Triumphant-24k/Pipelined-RISC-V-SoC/reports/submissions/Assignment_X_Back_End.pdf

ASSIGNMENT X - BACK END / GROUP PROJECT

# 32-bit RISC-V processor

## Floorplanning through routing, timing analysis and physical checks

Team member | Registration number | Lab slot
Shiv Sriram V | 24BVD0168 | L21+L22

Five elastic stages: instruction fetch, decode, execute, memory and writeback. The physical design includes the processor and its iterative multiply/divide unit. Instruction/data memory, caches, the accelerator and chip IO pads are outside this GDS boundary.

Implementation platform: public Nangate45 / FreePDK45, typical Liberty corner at 1.1 V and 25 C. Clock target: 10 ns. Results are measured from saved tool runs; limitations are identified alongside the corresponding checks.

Prepared against the supplied assignment question paper. Screenshots are actual tool windows captured on an isolated Linux X11 display; terminal figures explicitly review recorded logs. Full source, logs and databases accompany the project.

Shiv Sriram V | 24BVD0168 | L21+L22 | Evidence run: 24 October 2026 | 1

ASSIGNMENT X - BACK END / MEASURED OVERVIEW

# Implementation outcome and boundaries

Metric | Result
Physical top | rv32_pipeline including rv32_muldiv
Die dimensions | 292.425 x 292.425 um
Core dimensions | 272.270 x 270.200 um; area 73567.354 um2
Final cell area / utilization | 36606 um2 / 50% (tool-rounded; excludes filler inflation)
Post-route setup / hold slack | 6.31 ns / 0.02 ns; extracted RC, typical corner
Detailed-router design-rule markers | 0
Maximum-capacitance violations | 0 after final routed-RC extraction
Independent GDS DRC | 0 markers; see physical-verification section
LVS status | PASS: routed processor topology and all 443 named top ports match
Shiv Sriram V | 24BVD0168 | L21+L22 | Evidence run: 24 October 2026 | 2

ASSIGNMENT X - BACK END / IMPLEMENTATION METHOD

# Tools and reproducible environment

Tool / input | Version or identity
yosys | Yosys 0.9 (git sha1 1979e0b)
iverilog | Icarus Verilog version 11.0 (stable) ()
verilator | Verilator 4.038 2020-07-11 rev v4.036-114-g0cd4a57ad
openroad | v2.0-17598-ga008522d8
klayout | KLayout 0.30.12
gcc | riscv64-unknown-elf-gcc () 10.2.0

Platform checkout: 6101364b2d7909dd797e1e3e7f80695401cfa4e4. The official Ubuntu 22.04 OpenROAD release and its SHA256 are recorded in reports/toolchain_installation.json. No commercial libraries were required.

Shiv Sriram V | 24BVD0168 | L21+L22 | Evidence run: 24 October 2026 | 3

ASSIGNMENT X - BACK END / TERMINAL EVIDENCE

# Toolchain verification

Actual version-command output captured in xterm. The installation package and platform revision are pinned in the project.

Shiv Sriram V | 24BVD0168 | L21+L22 | Evidence run: 24 October 2026 | 4

ASSIGNMENT X - BACK END / IMPLEMENTATION AND RESULTS

# Floorplanning

A square floorplan targets 40% initial cell utilization with approximately 10 um core margins. Rows snap to the 0.19 x 1.4 um standard-cell site. Pins are distributed on metal5/metal6. The extra whitespace accommodates repair buffers and routing; no SRAM macros or IO pads are placed.

Metric | Measured result
Cell area | 29686.0 um2 (rounded by tool)
Cell utilization | 40% (rounded by tool)
Setup slack / hold slack | -5.64 ns / 0.03 ns
Database / reports | build/asic/2_floorplan.odb, .def, .sdc, _setup.rpt and _hold.rpt

Representative stage command: initialize_floorplan -utilization 40 -aspect_ratio 1 -core_space 10

Shiv Sriram V | 24BVD0168 | L21+L22 | Evidence run: 24 October 2026 | 5

ASSIGNMENT X - BACK END / TERMINAL EVIDENCE

# Floorplanning - tool results

Recorded stage metrics and the beginning of a real setup path from the corresponding STA report. Refer to the full report for every path arc.

Shiv Sriram V | 24BVD0168 | L21+L22 | Evidence run: 24 October 2026 | 6

ASSIGNMENT X - BACK END / GUI EVIDENCE

# Floorplanning - physical view

Actual OpenROAD view of 2_floorplan.odb. The stage database and constraints are loaded from the implementation output; no layout geometry is drawn for this report.

Shiv Sriram V | 24BVD0168 | L21+L22 | Evidence run: 24 October 2026 | 7

ASSIGNMENT X - BACK END / IMPLEMENTATION AND RESULTS

# Power planning

Global VDD/VSS connections feed metal1 follow-pin rails. Metal4 stripes are 0.48 um wide at 40 um pitch; metal7 straps are 1.4 um wide at 30 um pitch. A metal6/metal7 ring uses 1.4 um widths, 1.0 um spacing and 3.0 um core offset. Via connections join metal1-metal4, metal4-metal7 and metal6-metal7. The final power-grid check verifies connectivity, not package supply or IR-drop signoff.

Metric | Measured result
Cell area | 29686.0 um2 (rounded by tool)
Cell utilization | 40% (rounded by tool)
Setup slack / hold slack | -5.64 ns / 0.03 ns
Database / reports | build/asic/3_power.odb, .def, .sdc, _setup.rpt and _hold.rpt

Representative stage command: pdngen -failed_via_report build/asic/pdn_failed_vias.rpt

Shiv Sriram V | 24BVD0168 | L21+L22 | Evidence run: 24 October 2026 | 8

ASSIGNMENT X - BACK END / TERMINAL EVIDENCE

# Power planning - tool results

Recorded stage metrics and the beginning of a real setup path from the corresponding STA report. Refer to the full report for every path arc.

Shiv Sriram V | 24BVD0168 | L21+L22 | Evidence run: 24 October 2026 | 9

ASSIGNMENT X - BACK END / GUI EVIDENCE

# Power planning - physical view

Actual OpenROAD view of 3_power.odb. The stage database and constraints are loaded from the implementation output; no layout geometry is drawn for this report.

Shiv Sriram V | 24BVD0168 | L21+L22 | Evidence run: 24 October 2026 | 10

ASSIGNMENT X - BACK END / IMPLEMENTATION AND RESULTS

# Placement

Routability-driven global placement is followed by electrical repair, resizing and legalization. One-site padding reserves space between cells. Initial synthesis slew/capacitance violations motivate repair. The resulting area increase is reported separately from the synthesis area; placement is checked for overlaps and row/site legality.

Metric | Measured result
Cell area | 35694.0 um2 (rounded by tool)
Cell utilization | 49% (rounded by tool)
Setup slack / hold slack | 6.26 ns / 0.03 ns
Database / reports | build/asic/4_placement.odb, .def, .sdc, _setup.rpt and _hold.rpt

Representative stage command: global_placement -density 0.55 -routability_driven; detailed_placement

Shiv Sriram V | 24BVD0168 | L21+L22 | Evidence run: 24 October 2026 | 11

ASSIGNMENT X - BACK END / TERMINAL EVIDENCE

# Placement - tool results

Recorded stage metrics and the beginning of a real setup path from the corresponding STA report. Refer to the full report for every path arc.

Shiv Sriram V | 24BVD0168 | L21+L22 | Evidence run: 24 October 2026 | 12

ASSIGNMENT X - BACK END / GUI EVIDENCE

# Placement - physical view

Actual OpenROAD view of 4_placement.odb. The stage database and constraints are loaded from the implementation output; no layout geometry is drawn for this report.

Shiv Sriram V | 24BVD0168 | L21+L22 | Evidence run: 24 October 2026 | 13

ASSIGNMENT X - BACK END / IMPLEMENTATION AND RESULTS

# Clock tree synthesis

TritonCTS builds a clustered tree from the clk input. Clock inverters and clock nets are repaired, the new buffers are legalized and clocks become propagated for timing. The actual Clock Tree Viewer and stage log retain the clock-buffer hierarchy and counts. The original 0.2 ns hold uncertainty exhausted repair limits; the revised hold budget is 0.05 ns while setup stays 0.2 ns. This is a disclosed constraint revision, not closure against the earlier hold budget.

Metric | Measured result
Cell area | 36574.0 um2 (rounded by tool)
Cell utilization | 50% (rounded by tool)
Setup slack / hold slack | 6.47 ns / 0.02 ns
Database / reports | build/asic/5_cts.odb, .def, .sdc, _setup.rpt and _hold.rpt

Representative stage command: clock_tree_synthesis -root_buf CLKBUF_X3 -buf_list {CLKBUF_X1 CLKBUF_X2 CLKBUF_X3}

Shiv Sriram V | 24BVD0168 | L21+L22 | Evidence run: 24 October 2026 | 14

ASSIGNMENT X - BACK END / TERMINAL EVIDENCE

# Clock tree synthesis - tool results

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

Shiv Sriram V | 24BVD0168 | L21+L22 | Evidence run: 24 October 2026 | 15

ASSIGNMENT X - BACK END / GUI EVIDENCE

# Clock tree synthesis - physical view

Actual OpenROAD view of 5_cts.odb. The stage database and constraints are loaded from the implementation output; no layout geometry is drawn for this report.

Shiv Sriram V | 24BVD0168 | L21+L22 | Evidence run: 24 October 2026 | 16

ASSIGNMENT X - BACK END / IMPLEMENTATION AND RESULTS

# Global routing

Signals use metal2-metal6 and clocks metal4-metal6 to limit exposure to thick upper-metal antenna geometry. Routing capacities are reduced by 30% to reserve resources. The logged global-congestion table records the layer-by-layer overflow and resource use; the initial global-route guide wirelength is recorded in asic_metrics.json. Global routing writes guides for detailed routing. Timing here uses global-route parasitic estimates; it is not the extracted final timing.

Metric | Measured result
Cell area | 36606.0 um2 (rounded by tool)
Cell utilization | 50% (rounded by tool)
Setup slack / hold slack | 6.41 ns / 0.02 ns
Database / reports | build/asic/6_global_route.odb, .def, .sdc, _setup.rpt and _hold.rpt

Representative stage command: global_route -congestion_iterations 100 -verbose

Shiv Sriram V | 24BVD0168 | L21+L22 | Evidence run: 24 October 2026 | 17

ASSIGNMENT X - BACK END / TERMINAL EVIDENCE

# Global routing - tool results

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

Shiv Sriram V | 24BVD0168 | L21+L22 | Evidence run: 24 October 2026 | 18

ASSIGNMENT X - BACK END / GUI EVIDENCE

# Global routing - physical view

Actual OpenROAD view of 6_global_route.odb. The stage database and constraints are loaded from the implementation output; no layout geometry is drawn for this report.

Shiv Sriram V | 24BVD0168 | L21+L22 | Evidence run: 24 October 2026 | 19

ASSIGNMENT X - BACK END / IMPLEMENTATION AND RESULTS

# Detailed routing and extraction

Detailed routing resolves track assignment and vias using the guides. Standard-cell filler masters complete row gaps. The flow exports routed DEF and mapped Verilog, extracts routed RC with OpenRCX, writes/reads SPEF and reports setup/hold with propagated clocks. The final cell area is a logic/repair-area metric, not the die area or a full-chip pad/memory area.

Metric | Measured result
Cell area | 36606.0 um2 (rounded by tool)
Cell utilization | 50% (rounded by tool)
Setup slack / hold slack | 6.31 ns / 0.02 ns
Database / reports | build/asic/7_final.odb, .def, .sdc, _setup.rpt and _hold.rpt

Representative stage command: detailed_route; extract_parasitics; write_spef; read_spef

Shiv Sriram V | 24BVD0168 | L21+L22 | Evidence run: 24 October 2026 | 20

ASSIGNMENT X - BACK END / TERMINAL EVIDENCE

# Detailed routing and extraction - tool results

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

Shiv Sriram V | 24BVD0168 | L21+L22 | Evidence run: 24 October 2026 | 21

ASSIGNMENT X - BACK END / GUI EVIDENCE

# Detailed routing and extraction - physical view

Actual OpenROAD view of 7_final.odb. The stage database and constraints are loaded from the implementation output; no layout geometry is drawn for this report.

Shiv Sriram V | 24BVD0168 | L21+L22 | Evidence run: 24 October 2026 | 22

ASSIGNMENT X - BACK END / CTS GUI EVIDENCE

# Clock tree hierarchy in OpenROAD

Actual Clock Tree Viewer for core_clk after CTS. The buffer hierarchy supplements the placed clock-buffer view and recorded tree metrics.

Shiv Sriram V | 24BVD0168 | L21+L22 | Evidence run: 24 October 2026 | 23

ASSIGNMENT X - BACK END / CTS ISSUE EVIDENCE

# Hold-budget revision and failed attempts

Both failed logs are preserved. The final run uses a disclosed 50 ps hold uncertainty; it does not establish closure against the original 200 ps hold budget.

Shiv Sriram V | 24BVD0168 | L21+L22 | Evidence run: 24 October 2026 | 24

ASSIGNMENT X - BACK END / POST-PLACEMENT TO POST-ROUTE

# Timing analysis and closure assessment

Stage | Cell area (um2) | Util. | Setup slack (ns) | Hold slack (ns)
1_synth | 29686.0 | N/A | -5.64 | 0.03
4_placement | 35694.0 | 49% | 6.26 | 0.03
5_cts | 36574.0 | 50% | 6.47 | 0.02
6_global_route | 36606.0 | 50% | 6.41 | 0.02
7_final | 36606.0 | 50% | 6.31 | 0.02

Worst reported setup path: dp (input port clocked by core_clk) to _33164_ (rising edge-triggered flip-flop clocked by core_clk). Clock source/target latencies and the skew term are retained in the saved stage timing reports and final flow log. Setup uncertainty remains 0.2 ns.
Positive slack means the checked paths satisfy the specified single-corner constraints. The hold result applies to a 0.05 ns hold uncertainty; the original blanket 0.2 ns assumption failed repair. Input/output delays remain 1 ns. Setup uncertainty remains 0.2 ns.

Synthesis has no physical parasitics; placement uses placement estimates; global routing uses guide-based estimates; final timing uses extracted SPEF and propagated clocks. No fast/slow PVT analysis, process-variation derating, crosstalk signoff or package timing is claimed.

Shiv Sriram V | 24BVD0168 | L21+L22 | Evidence run: 24 October 2026 | 25

ASSIGNMENT X - BACK END / TIMING GUI EVIDENCE

# Post-route critical timing paths

OpenROAD Timing Report after loading final ODB, propagated-clock constraints and extracted SPEF. The detailed route does not by itself establish multi-corner signoff.

Shiv Sriram V | 24BVD0168 | L21+L22 | Evidence run: 24 October 2026 | 26

ASSIGNMENT X - BACK END / ELECTRICAL TERMINAL EVIDENCE

# Final electrical constraint check

The final extracted-RC checkpoint records the capacitance result after buffering, sizing, routing and extraction. Electrical limits are checked separately from setup/hold and geometry DRC.

Shiv Sriram V | 24BVD0168 | L21+L22 | Evidence run: 24 October 2026 | 27

ASSIGNMENT X - BACK END / INDEPENDENT CHECKS

# Physical verification and GDS export

KLayout imports routed DEF using the platform layer map, merges the Nangate standard-cell GDS masters and writes rv32_pipeline.gds. Every instantiated master is checked for non-empty geometry. This confirms stream-out completeness, rather than transistor-level equivalence.

Check | Outcome and interpretation
Detailed-router DRC | 0 final markers. This uses the router technology model and is distinct from GDS DRC.
Independent KLayout DRC | 0 markers using the public FreePDK45 rule deck, including FEOL, BEOL, grid and antenna rule groups.
Power connectivity | VDD/VSS grid checks pass; all 94,104 instance power/ground terminals connect to the expected supply. No supply bump/pad model or voltage-drop analysis was performed.
LVS | PASS: routed processor topology and all 443 named top ports match. An externally pinned FreePDK45 deck was adapted and validated against the installed Nangate cells.
Logical supplemental check | Directed scoreboard passes on mapped/post-route netlists at zero delay. This is not physical LVS or an SDF simulation.
Shiv Sriram V | 24BVD0168 | L21+L22 | Evidence run: 24 October 2026 | 28

ASSIGNMENT X - BACK END / PHYSICAL-VERIFICATION TERMINAL EVIDENCE

# Physical check results

Recorded stream-out and independent DRC status. Any nonzero count remains a reported limitation; gate simulation and power continuity do not replace LVS.

Shiv Sriram V | 24BVD0168 | L21+L22 | Evidence run: 24 October 2026 | 29

ASSIGNMENT X - BACK END / PHYSICAL-VERIFICATION GUI EVIDENCE

# GDS and independent DRC in KLayout

Final merged GDS loaded in KLayout, with the independent DRC results database. Marker categories identify the rules requiring review.

Shiv Sriram V | 24BVD0168 | L21+L22 | Evidence run: 24 October 2026 | 30

ASSIGNMENT X - BACK END / POWER TERMINAL EVIDENCE

# Instance power and ground connectivity

Explicit OpenDB audit of every POWER/GROUND instance terminal. Sizing protection is released before final global power connection; fixed placements are preserved. This supplements the PDN shape-continuity check.

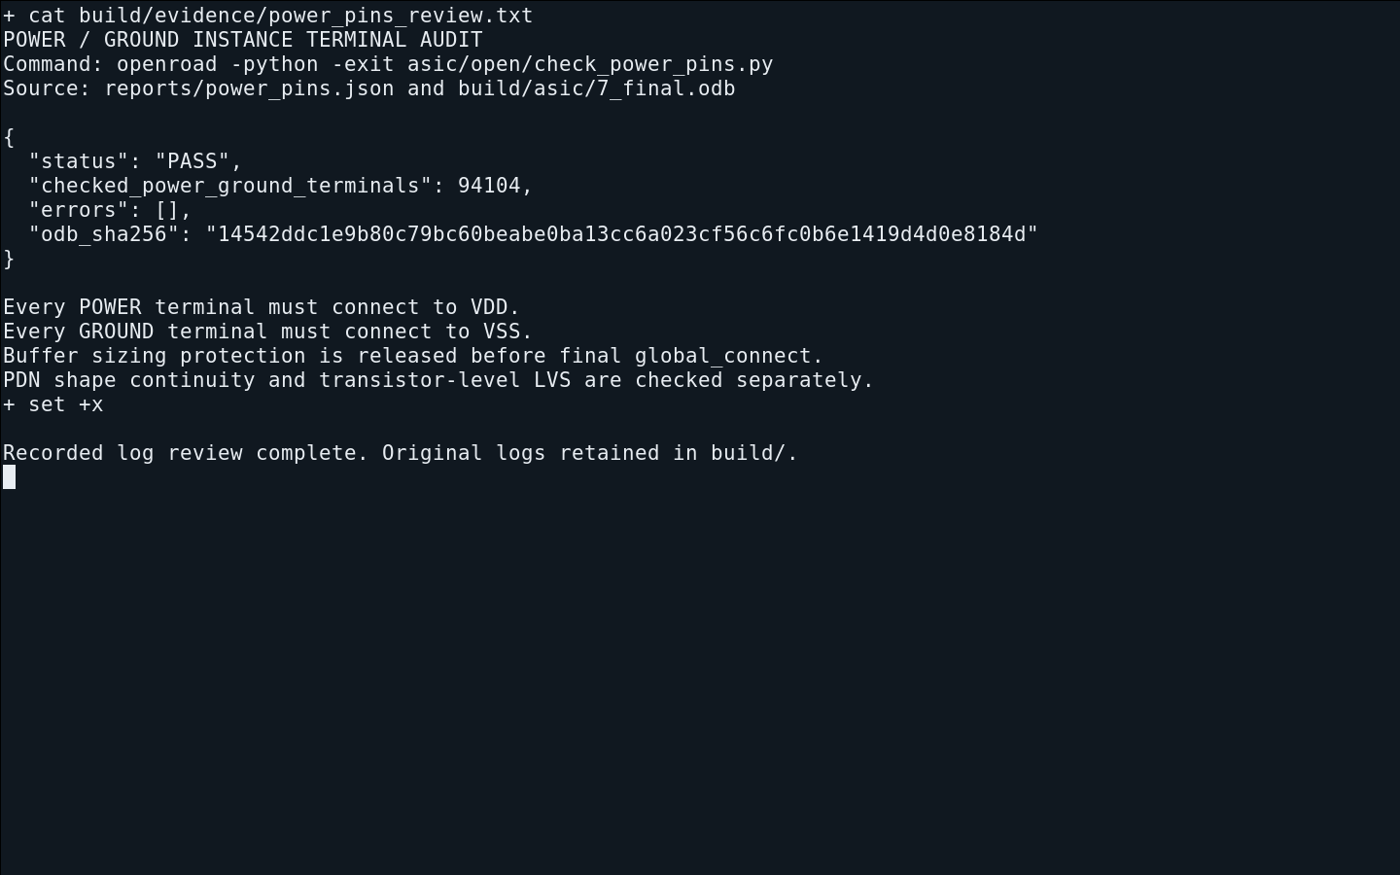
[picture p2: figure]

Shiv Sriram V | 24BVD0168 | L21+L22 | Evidence run: 24 October 2026 | 31

ASSIGNMENT X - BACK END / LAYOUT VERSUS SCHEMATIC

# LVS flow and validation

KLayout independently extracts transistor devices and routed connectivity from the final GDS. OpenROAD write_cdl exports the reference connectivity from the final database using the Nangate library pin order; the independent transistor-level library CDL is explicitly included.

The public FreePDK45_for_KLayout deck is pinned at d15da945559773854ca04aeb9bc2c150d55a1e6c, with the original BSD-3-Clause source and license retained. The adaptation removes unrelated OpenRAM cheat blocks, corrects MOS tolerance class names and adds an explicit verdict and named-port check.

Validation | Measured outcome
Basic positive fixtures | INV_X1 and DFF_X1: PASS
Transistor-width negative control | Double the inverter MOS widths: expected FAIL, observed FAIL
Port-label negative control | Swap A and ZN labels without altering geometry: expected FAIL, observed FAIL
Instantiated cell-master sweep | 83 functional masters: all PASS
Comparison validity | Nonempty processor and cell circuits; all circuit pairs and top-level relation pairs match.

MOS W/L tolerance: 1 nm absolute plus 0.1%. The deck follows the Nangate implicit-well convention: PWELL/BULK bind to VSS and NWELL to VDD. Only those well aliases are canonicalized; signal labels retain identity, with case normalized for SPICE. No processor or functional-cell black boxes are used.

Shiv Sriram V | 24BVD0168 | L21+L22 | Evidence run: 24 October 2026 | 32

ASSIGNMENT X - BACK END / LVS VALIDATION TERMINAL EVIDENCE

# LVS deck validation and negative controls

Positive checks must pass and intentionally incorrect references/layout labels must fail. The whole set of instantiated standard-cell masters is independently checked.

Shiv Sriram V | 24BVD0168 | L21+L22 | Evidence run: 24 October 2026 | 33

ASSIGNMENT X - BACK END / LVS VALIDATION GUI EVIDENCE

# Negative control rejected by LVS

The actual KLayout cross-reference browser shows a mismatch for the inverter whose reference transistor widths were deliberately doubled. This verifies that the flow detects a known defect.

Shiv Sriram V | 24BVD0168 | L21+L22 | Evidence run: 24 October 2026 | 34

ASSIGNMENT X - BACK END / MEASURED COMPARISON

# Processor LVS results

Metric | Result
Overall comparison | PASS
Matched circuit pairs | 84 (functional cell masters plus processor)
Matched named top-level pins | 443
Matched top-level nets | 21593
Matched standard-cell instances | 19030
Top-level port identities | PASS after SPICE letter-case normalization; bus indices preserved
Comparison duration | 357.65 seconds
Comparison log | 0 errors; 108 internal-net ambiguity warnings
Cross-reference database | build/lvs/processor.lvsdb

All compared circuits and top-level relation pairs report Match. The warning count above concerns ambiguous internal net assignments; every circuit still reports Match and no comparison errors remain. LVS does not verify path delay, antenna limits or maximum-capacitance limits.

Shiv Sriram V | 24BVD0168 | L21+L22 | Evidence run: 24 October 2026 | 35

ASSIGNMENT X - BACK END / LVS TERMINAL EVIDENCE

# Routed processor LVS and named-port audit

Actual recorded verdict and audited comparison counts. Input fingerprints in lvs_summary.json bind this result to the checked GDS, reference netlist and final OpenROAD database.

Shiv Sriram V | 24BVD0168 | L21+L22 | Evidence run: 24 October 2026 | 36

ASSIGNMENT X - BACK END / LVS GUI EVIDENCE

# Processor LVS cross-reference in KLayout

Actual native LVS database browser. Green circuit relations indicate matched extracted and reference circuits. The saved database supports further net, pin, device and instance inspection.

Shiv Sriram V | 24BVD0168 | L21+L22 | Evidence run: 24 October 2026 | 37

ASSIGNMENT X - BACK END / REPAIR AND REPEATED VERIFICATION

# Antenna and electrical closure

Check | Original routed core | Repaired routed core
Independent GDS antenna markers | 43 | 0
Maximum-capacitance violations | 8; worst excess 11.10 fF | 0
Cell area (um2; tool-rounded) | 36,027 | 36606.0
Detailed-router markers | 0 | 0
Extracted setup / hold slack | +6.44 / +0.02 ns | +6.31 / +0.02 ns
LVS | PASS before repair | PASS on the new GDS

Repair anchors real input buffers at legal sites near their core pins, protects them against removal/resizing, and anchors the CTS root near clk. It restricts signal/clock routing to metals 2-6/4-6, and applies electrical repair using global-route parasitics with a 20% capacitance margin and 10% slew margin. Cells are legalized and affected nets re-routed before detailed routing. Final extraction, GDS DRC, routed netlist simulation and transistor-level LVS are repeated.

The original Nangate antenna cell has zero declared diffusion area and an empty CDL device body. It was not used as an unverified diode repair. No DRC rules or Liberty capacitance limits were relaxed, and no antenna markers were waived.

Shiv Sriram V | 24BVD0168 | L21+L22 | Evidence run: 24 October 2026 | 38

ASSIGNMENT X - BACK END / REPAIR HISTORY - ACTUAL GUI EVIDENCE

# Intermediate repair: antenna check still fails

The first candidate cleared capacitance but left small-input-gate buffers free to move toward internal loads. The independent deck reported 79 antenna markers, so this candidate was rejected. The final repair anchors and protects the input buffers and CTS root.

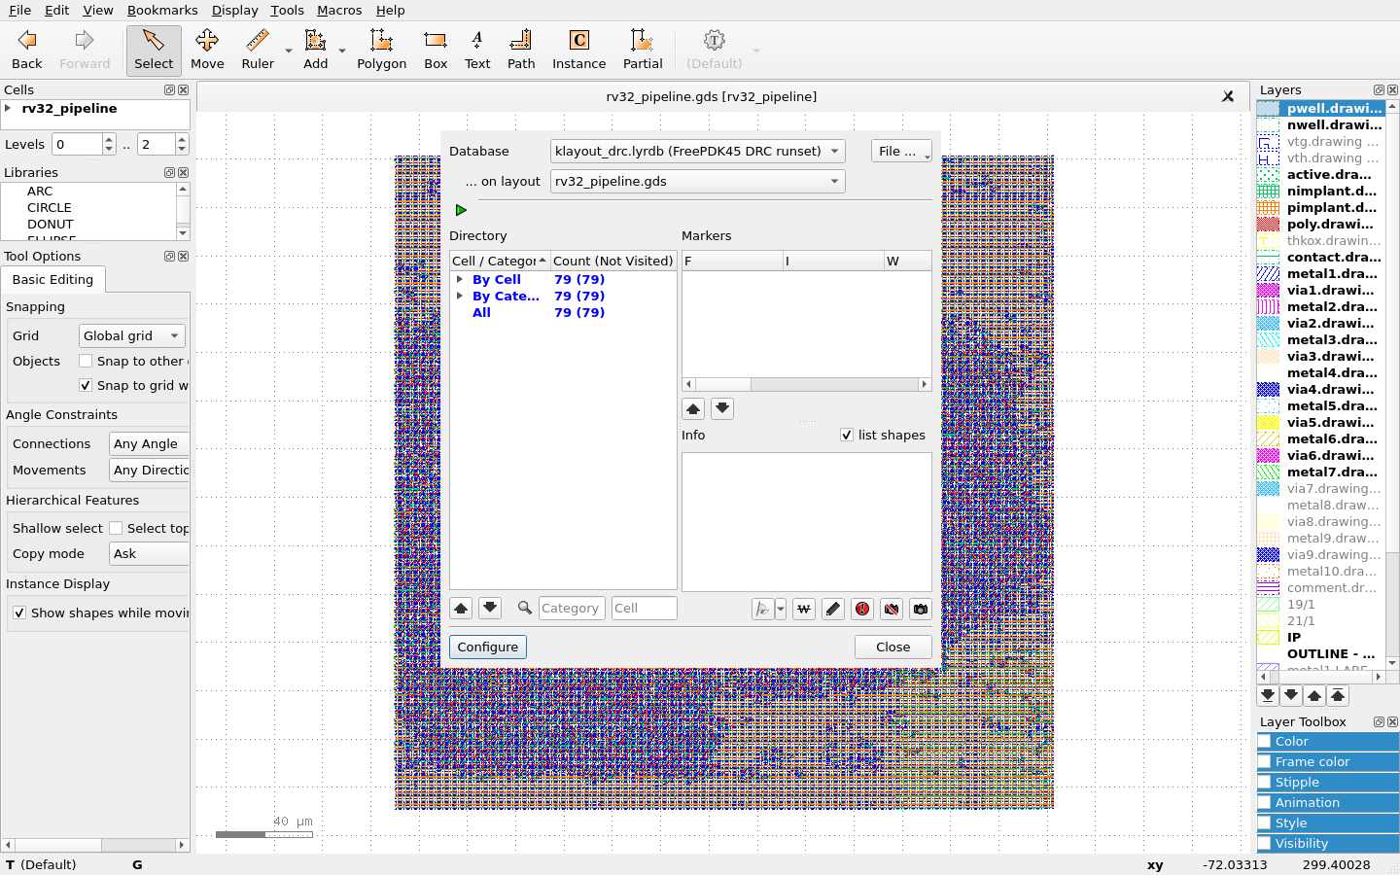
[picture p3: figure]

Shiv Sriram V | 24BVD0168 | L21+L22 | Evidence run: 24 October 2026 | 39

ASSIGNMENT X - BACK END / REPAIR HISTORY - TERMINAL EVIDENCE

# Rejected candidate - measured check results

Actual saved DRC and electrical results for the intermediate candidate. These are repair-history measurements and are not the final submitted layout result.

Shiv Sriram V | 24BVD0168 | L21+L22 | Evidence run: 24 October 2026 | 40

ASSIGNMENT X - BACK END / REPAIR TERMINAL EVIDENCE

# Electrical repair commands and tool output

Recorded OpenROAD repair output and the exact buffering, routing and margin commands from the reproducible physical flow.

Shiv Sriram V | 24BVD0168 | L21+L22 | Evidence run: 24 October 2026 | 41

ASSIGNMENT X - BACK END / FINAL TERMINAL EVIDENCE

# Final physical closure audit

The audit requires current GDS/ODB/deck fingerprints, zero GDS and router markers, zero capacitance violations, nonnegative setup/hold slack, passing routed simulation, power connectivity and passing LVS.

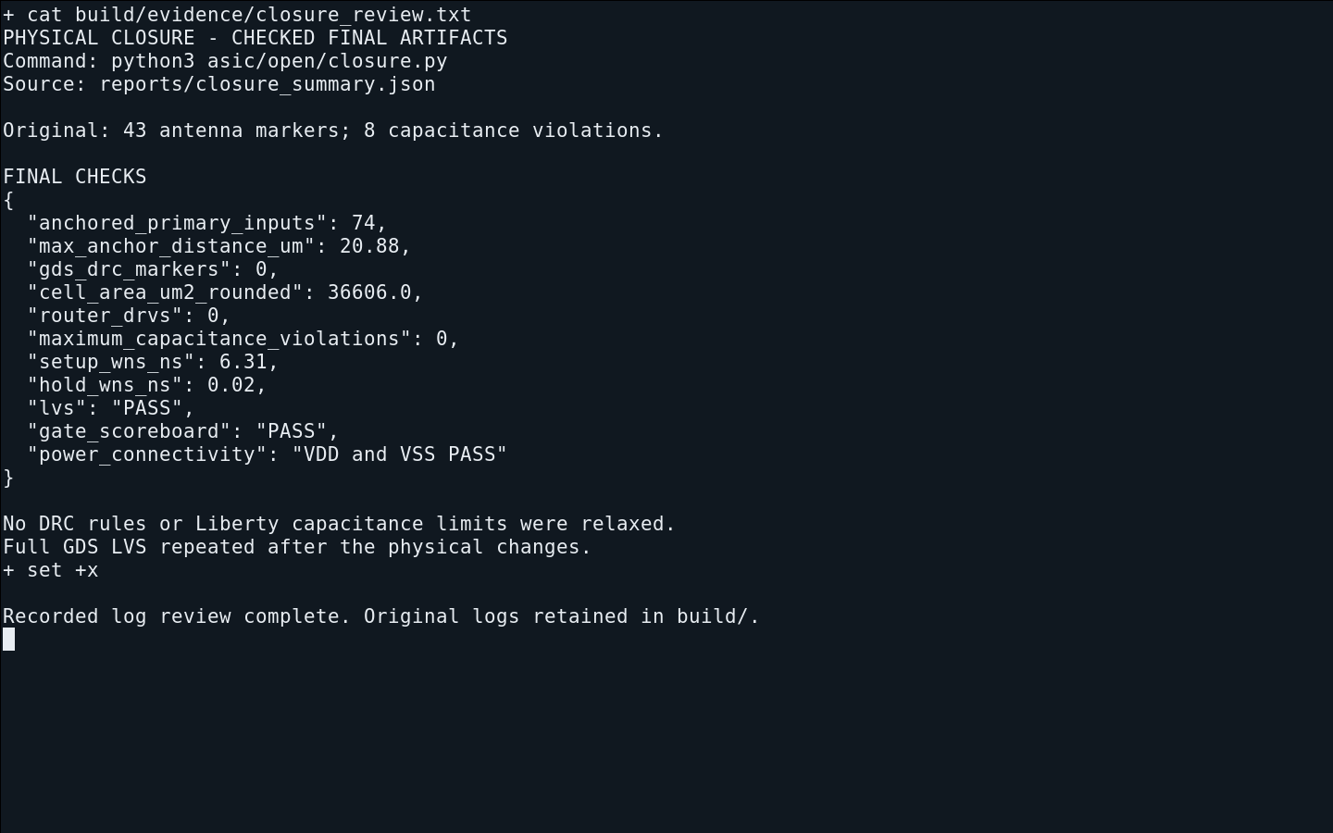
[picture p4: figure]

Shiv Sriram V | 24BVD0168 | L21+L22 | Evidence run: 24 October 2026 | 42

ASSIGNMENT X - BACK END / REPAIR HISTORY - ACTUAL GUI EVIDENCE

# Original antenna markers before repair

Preserved KLayout view of the original 43-marker result. The final repeated independent check appears earlier in this report.

Shiv Sriram V | 24BVD0168 | L21+L22 | Evidence run: 24 October 2026 | 43

ASSIGNMENT X - BACK END / REPAIR HISTORY - ACTUAL TERMINAL EVIDENCE

# Original capacitance violations before repair

Preserved original extracted result: eight violating pins, with worst excess 11.10 fF. The final electrical check appears earlier in this report.

Shiv Sriram V | 24BVD0168 | L21+L22 | Evidence run: 24 October 2026 | 44

ASSIGNMENT X - BACK END / DISCUSSION OF RESULTS

# Implementation scope and remaining limits

The repaired result is assessed against the same enabled public FreePDK45 DRC rules, Nangate Liberty limits and 10 ns clock constraint. Exact check counts, timing and input fingerprints are retained in the attached machine-readable reports.

Hierarchical transistor-level LVS passes under the documented public-PDK extraction and well-bias assumptions. External memory, a pad ring, package power entry and a physical SRAM implementation remain outside this core project.

Timing and area are educational typical-corner measurements. The disclosed hold uncertainty is 0.05 ns. Multi-corner timing, voltage-drop analysis and power consumption with representative activity have not been performed. The exported GDS is an academic routed core implementation; this result does not establish foundry signoff.

Shiv Sriram V | 24BVD0168 | L21+L22 | Evidence run: 24 October 2026 | 45

ASSIGNMENT X - BACK END / PROJECT RECORD

# Contributions, scope and reproduction

Contributor / assistance | Recorded role
Shiv Sriram V, 24BVD0168 | Project owner; supplied the processor proposal and existing project repository. No additional team members were provided.
Existing repository | Processor, optional SoC extensions, firmware and regression infrastructure predated this session.
AI-assisted work in this session | Open-source floorplan, PDN, placement, CTS, routing, extraction, GDS export, antenna/electrical repair, independent DRC/LVS, power audit and evidence/report preparation; tool execution, evidence capture and report compilation. Student review and approval of the submitted claims remain with the project owner.

No commits were made or staged. Suggested stage-by-stage commit messages and file groupings are in docs/COMMIT_GUIDE.md. The project includes exact constraints, source scripts, tool outputs and screenshots for independent reproduction.

make pipeline
make all
python3 asic/open/synth.py make closure
make evidence
make submissions
Shiv Sriram V | 24BVD0168 | L21+L22 | Evidence run: 24 October 2026 | 46

ASSIGNMENT X - BACK END / REFERENCES

# Source and evidence index

Assignment sources: the supplied Assignment VIII project proposal; ASIC Design Lab QP 9 (1).pdf (Assignment IX, Front End); ASIC Design Lab QP 0.pdf (Assignment X, Back End). Submission 8 duplicates the supplied proposal.

OpenROAD flow and public platform documentation:
https://openroad-flow-scripts.readthedocs.io/en/latest/
Official binary release:
https://github.com/Precision-Innovations/OpenROAD/releases/tag/2024-12-14 LVS source: FreePDK45_for_KLayout - pinned BSD-3-Clause source and license (https://github.com/laurentc2/FreePDK45_for_KLayout/tree/d15da945559773854ca04aeb9bc2c150d55a1e6c)
Evidence location | Content
rtl/ and tb/ | Synthesizable sources and independent directed scoreboard
build/evidence/ | Full regression, hazard/gate logs and waveforms; terminal review text
build/asic/ | Synthesis log/netlist/JSON; ODB, DEF, SDC, STA paths, SPEF, GDS and DRC database
reports/asic_metrics.json | Measured area, utilization, setup/hold slack and tool/platform versions
reports/physical_checks.json | Independent GDS DRC and measured LVS status
reports/lvs_summary.json | Validated cell masters, negative controls and processor comparison counts
reports/closure_summary.json | Final DRC, electrical, timing, functional, power and LVS audit
reports/evidence/ | Unaltered actual GUI and xterm screenshot PNG files
asic/open/README.md | Reproduction, constraints, scope and tool setup
Shiv Sriram V | 24BVD0168 | L21+L22 | Evidence run: 24 October 2026 | 47
