Triumphant-24k/Pipelined-RISC-V-SoC/reports/submissions/Assignment_IX_Front_End.pdf

ASSIGNMENT IX - FRONT END / GROUP PROJECT

# 32-bit RISC-V processor

## RTL implementation, functional verification and logic synthesis

Team member | Registration number | Lab slot
Shiv Sriram V | 24BVD0168 | L21+L22

Five elastic stages: instruction fetch, decode, execute, memory and writeback. The physical design includes the processor and its iterative multiply/divide unit. Instruction/data memory, caches, the accelerator and chip IO pads are outside this GDS boundary.

Implementation platform: public Nangate45 / FreePDK45, typical Liberty corner at 1.1 V and 25 C. Clock target: 10 ns. Results are measured from saved tool runs; limitations are identified alongside the corresponding checks.

Prepared against the supplied assignment question paper. Screenshots are actual tool windows captured on an isolated Linux X11 display; terminal figures explicitly review recorded logs. Full source, logs and databases accompany the project.

Shiv Sriram V | 24BVD0168 | L21+L22 | Evidence run: 24 October 2026 | 1

ASSIGNMENT IX - FRONT END / IMPLEMENTATION METHOD

# Tools and reproducible environment

Tool / input | Version or identity
yosys | Yosys 0.9 (git sha1 1979e0b)
iverilog | Icarus Verilog version 11.0 (stable) ()
verilator | Verilator 4.038 2020-07-11 rev v4.036-114-g0cd4a57ad
openroad | v2.0-17598-ga008522d8
klayout | KLayout 0.30.12
gcc | riscv64-unknown-elf-gcc () 10.2.0

Platform checkout: 6101364b2d7909dd797e1e3e7f80695401cfa4e4. The official Ubuntu 22.04 OpenROAD release and its SHA256 are recorded in reports/toolchain_installation.json. No commercial libraries were required.

Shiv Sriram V | 24BVD0168 | L21+L22 | Evidence run: 24 October 2026 | 2

ASSIGNMENT IX - FRONT END / TERMINAL EVIDENCE

# Toolchain verification

Actual version-command output captured in xterm. The installation package and platform revision are pinned in the project.

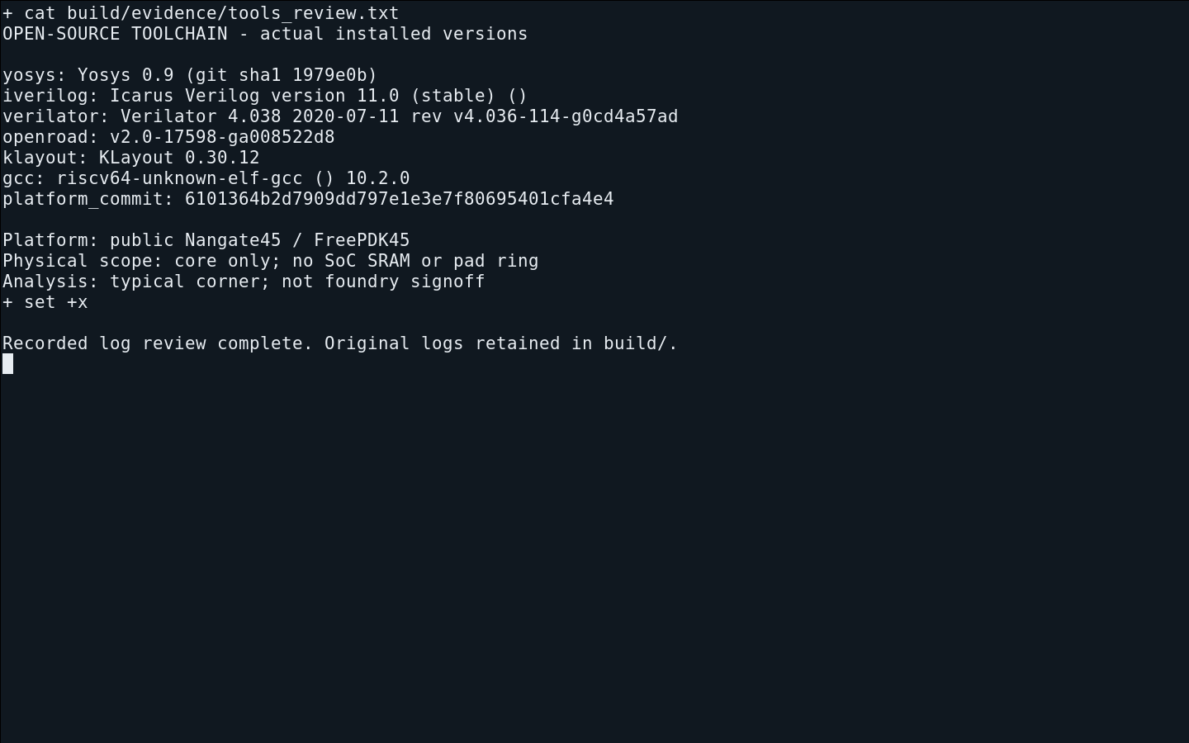
[picture p5: figure]

Shiv Sriram V | 24BVD0168 | L21+L22 | Evidence run: 24 October 2026 | 3

ASSIGNMENT IX - FRONT END / RTL IMPLEMENTATION

# Design hierarchy and stage responsibilities

Block | Implementation and purpose
rv32_pipeline | Physical top. Register file, decode/immediates, five valid-controlled stages, bypassing, memory handshakes, redirect/exception control, counters and machine CSRs.
rv32_muldiv | Iterative RV32M arithmetic unit. Blocks EX until the result is ready; signed and unsigned multiply/divide/remainder cases.
pipeline_evidence_tb | Directed test with an independent architectural scoreboard and explicit coverage counters.
cpu_tb and isa_reference.py | Randomized request/response latency; retirement trace checked against an independent instruction interpreter.
pipelined_soc and component RTL | Separately verified cache/fabric/accelerator extension; excluded from the core physical implementation.

This retains the proposed processor idea while using the existing RV32IM implementation. The fetch frontend has one outstanding request and does not sustain one instruction per cycle. No pipeline speedup or ISA certification is inferred from the five-stage structure.

Shiv Sriram V | 24BVD0168 | L21+L22 | Evidence run: 24 October 2026 | 4

ASSIGNMENT IX - FRONT END / ARCHITECTURE

# Five-stage data and control flow

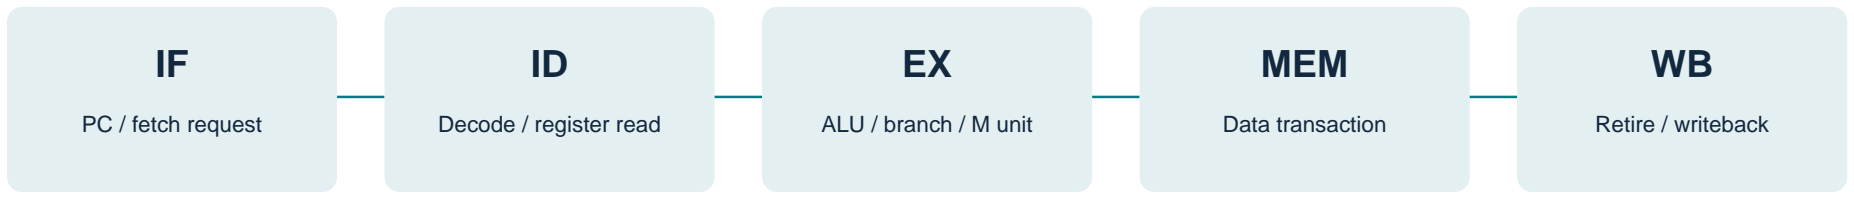
[picture p6: figure]
PC / fetch request; Decode / register read; ALU / branch / M unit; MEM; Data transaction; Retire / writeback

Stage registers carry PC, instruction, operand values and control state. A valid/ready-style elastic transfer allows MEM or EX to wait without losing instruction state. Stores use byte strobes; loads shift and extend the selected byte or halfword.

Bypasses select the newest matching result from the EX/MEM and MEM/WB paths. A dependent instruction waits while a load result is unavailable. Taken branches, JAL/JALR and exceptions cancel younger instructions and redirect fetch; pending wrong-path responses are marked killed.

The register file forces x0 to zero. CSR and fence operations serialize as needed. The machine-mode environment includes directed exception and interrupt support, but does not implement an MMU, user/supervisor modes or a full privileged architecture.

Shiv Sriram V | 24BVD0168 | L21+L22 | Evidence run: 24 October 2026 | 5

ASSIGNMENT IX - FRONT END / RTL TERMINAL EVIDENCE

# RTL control source

Source review of the load-use interlock, redirect condition and data interface assignments. Complete modules are supplied under rtl/.

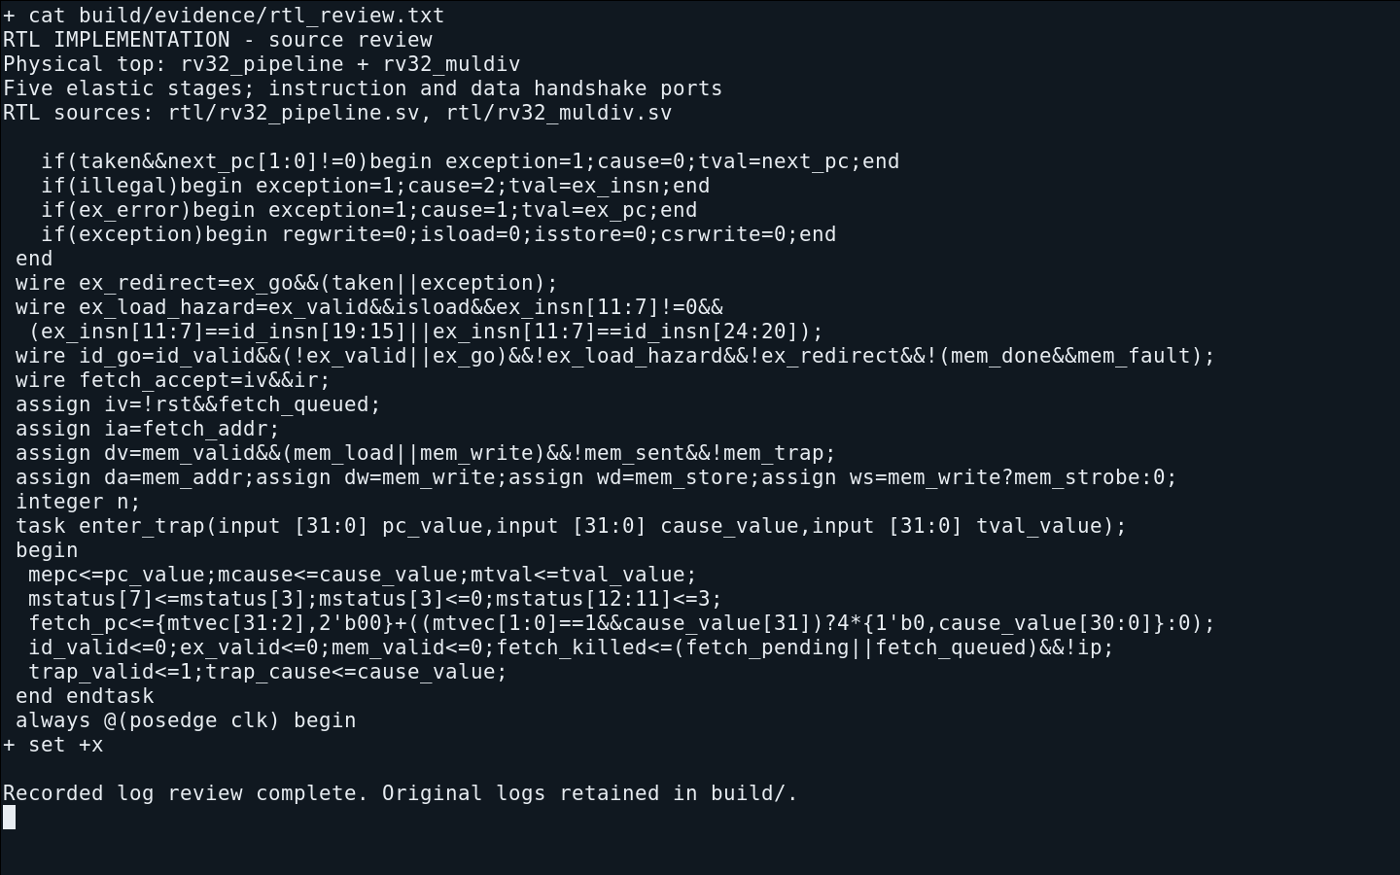
[picture p7: figure]

Shiv Sriram V | 24BVD0168 | L21+L22 | Evidence run: 24 October 2026 | 6

ASSIGNMENT IX - FRONT END / RELEVANT RTL EXCERPT

# Forwarding and load-use control

Exact source excerpts from rv32_pipeline.sv. The newest valid result wins bypass priority; the interlock prevents a dependent ID instruction from consuming an unavailable load result.

(wb_valid&&wb_regwrite&&wb_rd!=0&&wb_rd==ex_rs1)?wb_value:ex_a;
wire [31:0] b=(mem_valid&&mem_regwrite&&!mem_fault&&mem_rd!=0&&mem_rd==ex_rs2&&(!mem_load||mem_done))?mem_value: (wb_valid&&wb_regwrite&&wb_rd!=0&&wb_rd==ex_rs2)?wb_value:ex_b;
reg [31:0] result,address,store_data,next_pc,tval,csr_old,csr_new;
reg [31:0] cause;
reg regwrite,isload,isstore,illegal,taken,exception,csrwrite,is_mret,is_fencei,csr_ok; reg [3:0] strobes;

integer n;
task enter_trap(input [31:0] pc_value,input [31:0] cause_value,input [31:0] tval_value); begin
mepc<=pc_value;mcause<=cause_value;mtval<=tval_value; mstatus[7]<=mstatus[3];mstatus[3]<=0;mstatus[12:11]<=3; fetch_pc<={mtvec[31:2],2'b00}+((mtvec[1:0]==1&&cause_value[31])?4*{1'b0,cause_value[30:0]}:0); id_valid<=0;ex_valid<=0;mem_valid<=0;fetch_killed<=(fetch_pending||fetch_queued)&&!ip; trap_valid<=1;trap_cause<=cause_value;
end endtask

Complete rv32_pipeline.sv, rv32_muldiv.sv and pipeline_evidence_tb.sv are embedded as file attachments in this PDF and supplied as normal project files.

Shiv Sriram V | 24BVD0168 | L21+L22 | Evidence run: 24 October 2026 | 7

ASSIGNMENT IX - FRONT END / RELEVANT RTL EXCERPT

# Stage transfer and architectural writeback

Exact stage-transfer source: ID captures operand values with bypassing, and WB exposes retirement and updates the architectural register file. Valid bits govern which payloads are meaningful.

if(id_go)begin
id_valid<=0;ex_valid<=1;ex_pc<=id_pc;ex_insn<=id_insn;ex_error<=id_error; ex_a<=id_insn[19:15]==0?0:
(ex_go&&regwrite&&ex_insn[11:7]==id_insn[19:15])?result: (mem_valid&&mem_regwrite&&!mem_fault&&mem_rd==id_insn[19:15]&&(!mem_load||mem_done))?mem_value: (wb_valid&&wb_regwrite&&wb_rd==id_insn[19:15])?wb_value:regs[id_insn[19:15]]; ex_b<=id_insn[24:20]==0?0:
(ex_go&&regwrite&&ex_insn[11:7]==id_insn[24:20])?result: (mem_valid&&mem_regwrite&&!mem_fault&&mem_rd==id_insn[24:20]&&(!mem_load||mem_done))?mem_value: (wb_valid&&wb_regwrite&&wb_rd==id_insn[24:20])?wb_value:regs[id_insn[24:20]];
end
if(dv&&dr)mem_sent<=1;
if(wb_valid)begin
retire_valid<=1;retire_pc<=wb_pc;retire_insn<=wb_insn; retire_rd<=wb_regwrite?wb_rd:0;retire_value<=wb_value;instret<=instret+1; if(wb_regwrite&&wb_rd!=0)regs[wb_rd]<=wb_value; if(wb_csrwrite)case(wb_csraddr)
12'h300:mstatus<=(wb_csrvalue&32'h88)|32'h1800;
12'h304:mie<=wb_csrvalue&32'h880; 12'h305:mtvec<={wb_csrvalue[31:2],1'b0,wb_csrvalue[0]};12'h340:mscratch<=wb_csrvalue; 12'h341:mepc<={wb_csrvalue[31:2],2'd0};12'h342:mcause<=wb_csrvalue;12'h343:mtval<=wb_csrvalue; 12'hb00:cycles[31:0]<=wb_csrvalue;12'hb80:cycles[63:32]<=wb_csrvalue; 12'hb02:instret[31:0]<=wb_csrvalue;12'hb82:instret[63:32]<=wb_csrvalue;
default:begin end
Shiv Sriram V | 24BVD0168 | L21+L22 | Evidence run: 24 October 2026 | 8

ASSIGNMENT IX - FRONT END / FUNCTIONAL VERIFICATION

# Verification plan and measured coverage

Requirement / test | Measured evidence
Forwarding and load-use stall | Directed test: forwarding=2; load-use stall=13 cycles; architectural scoreboard passes.
Control hazards | Two redirects; PC 0x20 and 0x28 are forbidden from retirement; taken and untaken branches plus JAL checked.
Architectural state | Expected x1=7, x2=12, x3=12, x4=24, x6=0, x7=x8=40. Test finishes at cycle 70 with 12 retirements observed before the exit-store response.
RV32M arithmetic | 520 multiply/divide test vectors including edge cases.
CPU differential verification | 8176 retirements at delay 0; 8176 retirements at delay 3; 8176 retirements at delay 7.
Architectural suite | 49 passing programs; adapted riscv-tests environment, not certification.
Additional regression | Cache, AXI adapter, traps, matrix/DMA and integrated firmware sweeps; fatal lint and a 25-cycle bounded arbiter safety proof.
Shiv Sriram V | 24BVD0168 | L21+L22 | Evidence run: 24 October 2026 | 9

ASSIGNMENT IX - FRONT END / SIMULATION TERMINAL EVIDENCE

# Directed pipeline test results

The recorded run prints each retirement and the scoreboard/coverage result. Wrong-path instructions are rejected by PC; the exit store completes after the reported 12 retirements.

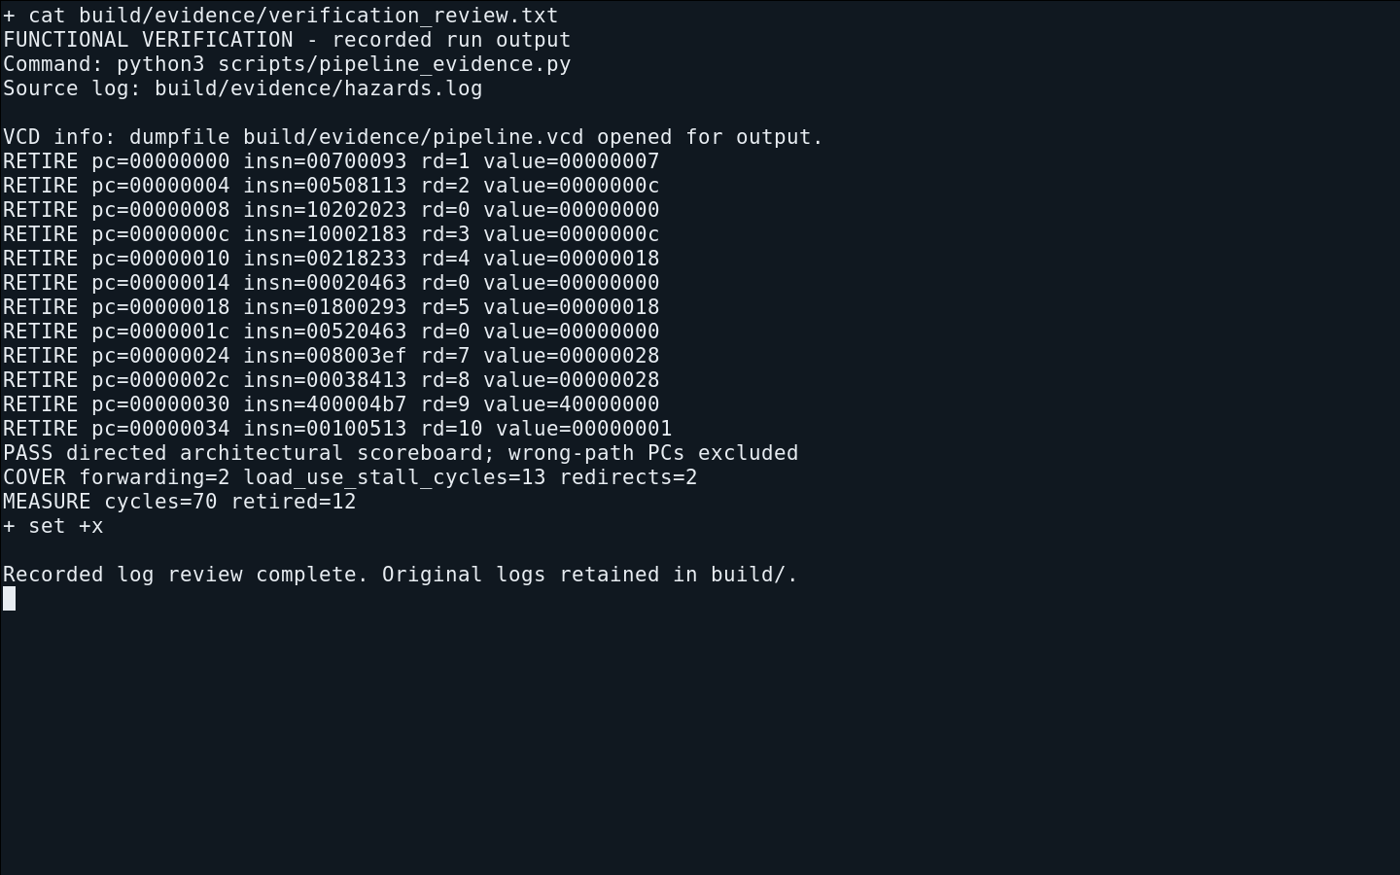
[picture p8: figure]

Shiv Sriram V | 24BVD0168 | L21+L22 | Evidence run: 24 October 2026 | 10

ASSIGNMENT IX - FRONT END / SIMULATION GUI EVIDENCE

# Pipeline waveform in GTKWave

The asserted load-hazard interval holds ID while memory is busy. ex_redirect pulses correspond to the taken branch and jump. X values before a stage becomes valid are uninitialized, invalid payloads.

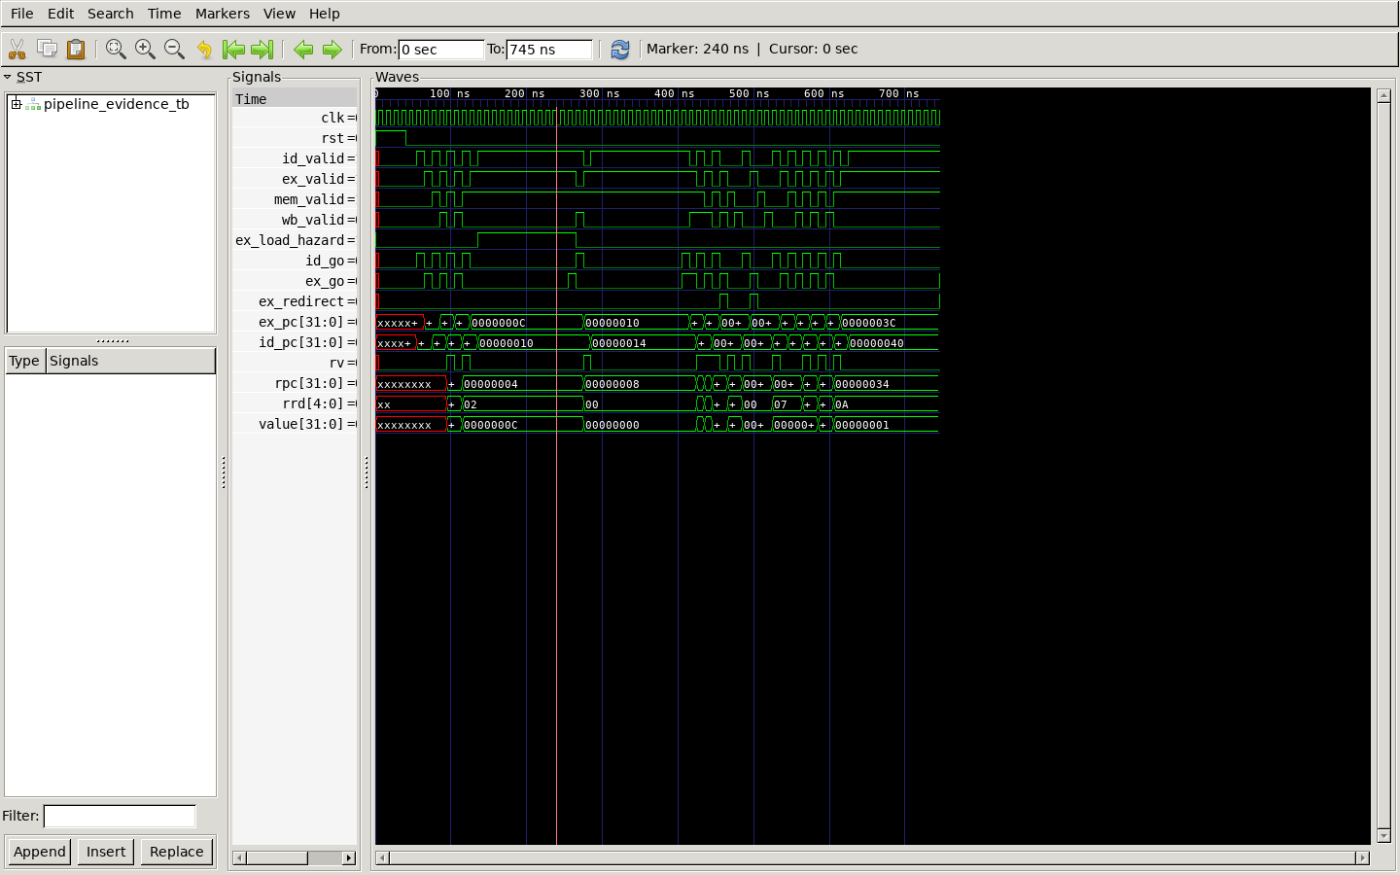
[picture p9: figure]

Shiv Sriram V | 24BVD0168 | L21+L22 | Evidence run: 24 October 2026 | 11

ASSIGNMENT IX - FRONT END / REGRESSION TERMINAL EVIDENCE

# Full regression and reference comparisons

Saved make all output and generated JSON results. Whole-SoC checks extend beyond the processor core that is physically implemented.

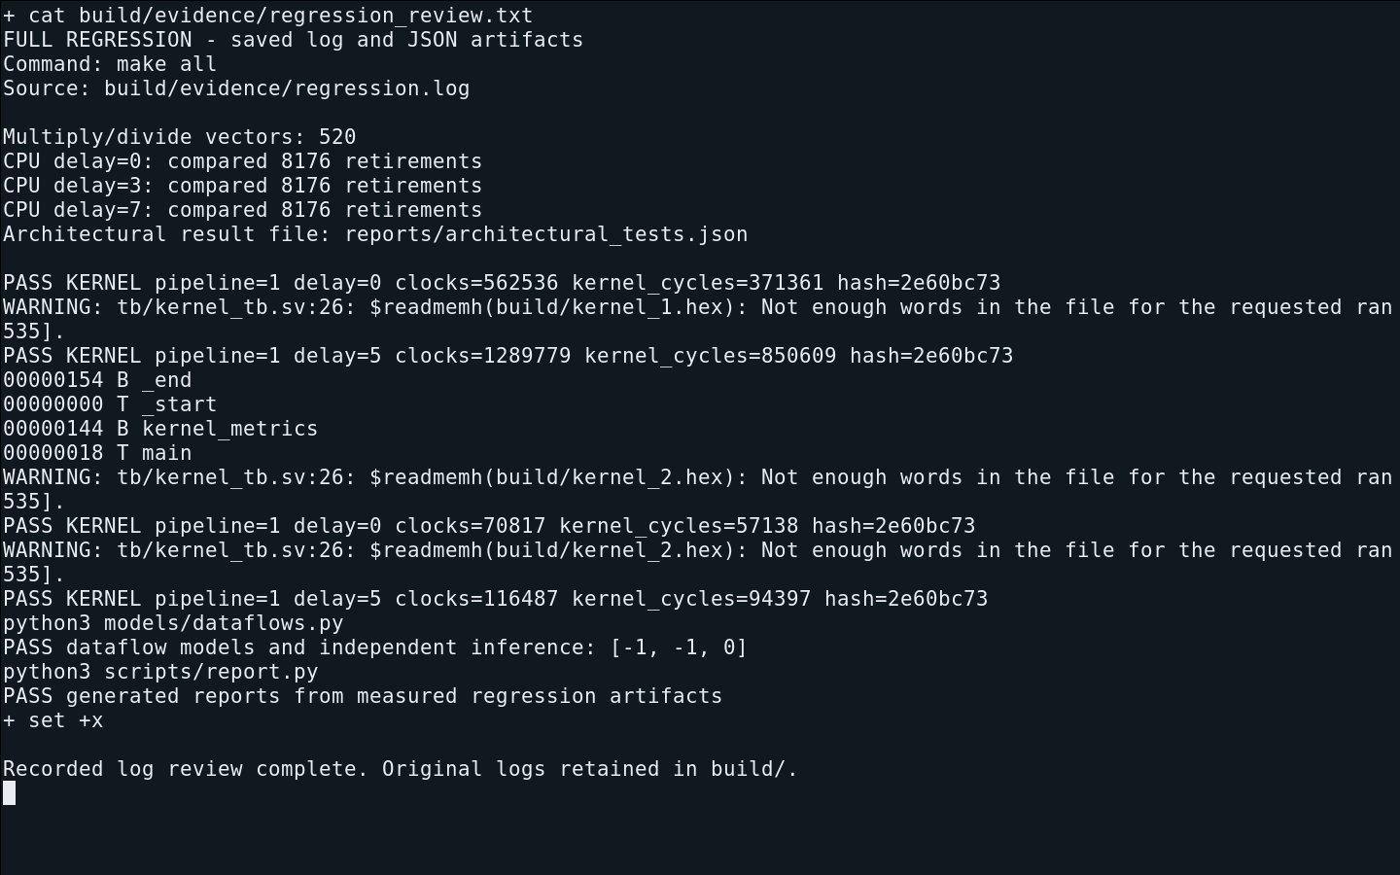
[picture p10: figure]

Shiv Sriram V | 24BVD0168 | L21+L22 | Evidence run: 24 October 2026 | 12

ASSIGNMENT IX - FRONT END / LOGIC SYNTHESIS

# Technology synthesis flow and constraints

Yosys elaborates and flattens rv32_pipeline and rv32_muldiv, lowers processes and memories, maps flip-flops with dfflibmap, then maps combinational logic through ABC using the Nangate45 typical Liberty library. Tie cells implement constants. Structural checks run before and after mapping.

read_verilog -sv rtl/rv32_pipeline.sv rtl/rv32_muldiv.sv
synth -top rv32_pipeline -flatten
dfflibmap -liberty NangateOpenCellLibrary_typical.lib abc -liberty NangateOpenCellLibrary_typical.lib -D 10000 hilomap -hicell LOGIC1_X1 Z -locell LOGIC0_X1 Z
check -assert
write_verilog -noattr -noexpr build/asic/1_synth.v

The 10 ns clock is a target. IO budgets are 1 ns; output load is 0.01 pF and input transition 0.1 ns. Setup uncertainty is 0.2 ns and hold uncertainty 0.05 ns. The register file maps to standard cells; no instruction/data SRAM is part of synthesis.

Shiv Sriram V | 24BVD0168 | L21+L22 | Evidence run: 24 October 2026 | 13

ASSIGNMENT IX - FRONT END / MAPPED DESIGN

# Synthesis results and interpretation

Metric | Measured result
Mapped cells | 17,853 cells including tie cells
Mapped cell area | 29,685.866 square micrometres
Clock / corner | 10 ns; Nangate45 typical, 1.1 V / 25 C
Initial setup slack | -5.64 ns; ideal clock, no routed interconnect
Initial hold slack | 0.03 ns under the revised 0.05 ns hold uncertainty
Inference boundary | Core register file and arithmetic are mapped; external memory and optional SoC modules are excluded.

Initial synthesis timing does not meet the setup target and includes electrical violations from the minimally driven mapped netlist. Physical placement and repair resize cells and insert buffers; the later back-end report presents those measured improvements. Initial synthesis slack is not a post-route frequency result.

Shiv Sriram V | 24BVD0168 | L21+L22 | Evidence run: 24 October 2026 | 14

ASSIGNMENT IX - FRONT END / SYNTHESIS TERMINAL EVIDENCE

# Mapped Yosys synthesis output

Recorded standard-cell statistics and Liberty area. The area excludes external instruction/data memories, caches, accelerator and IO pads.

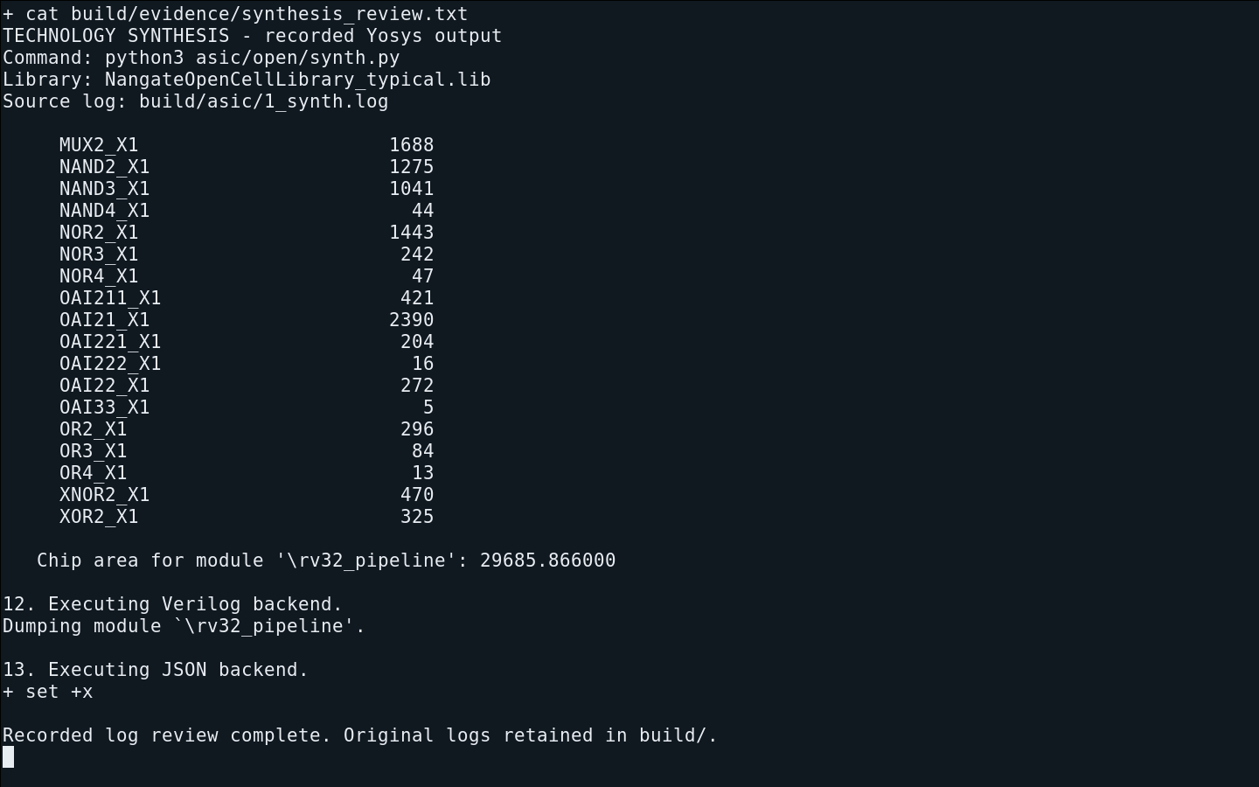
[picture p11: figure]

Shiv Sriram V | 24BVD0168 | L21+L22 | Evidence run: 24 October 2026 | 15

ASSIGNMENT IX - FRONT END / SYNTHESIS GUI EVIDENCE

# Initial timing paths in OpenROAD

The mapped netlist is loaded into the OpenROAD Timing Report. No placement geometry is expected at this stage; timing is based on ideal interconnect. The displayed 100% is an unplaced-tool default, not physical core utilization.

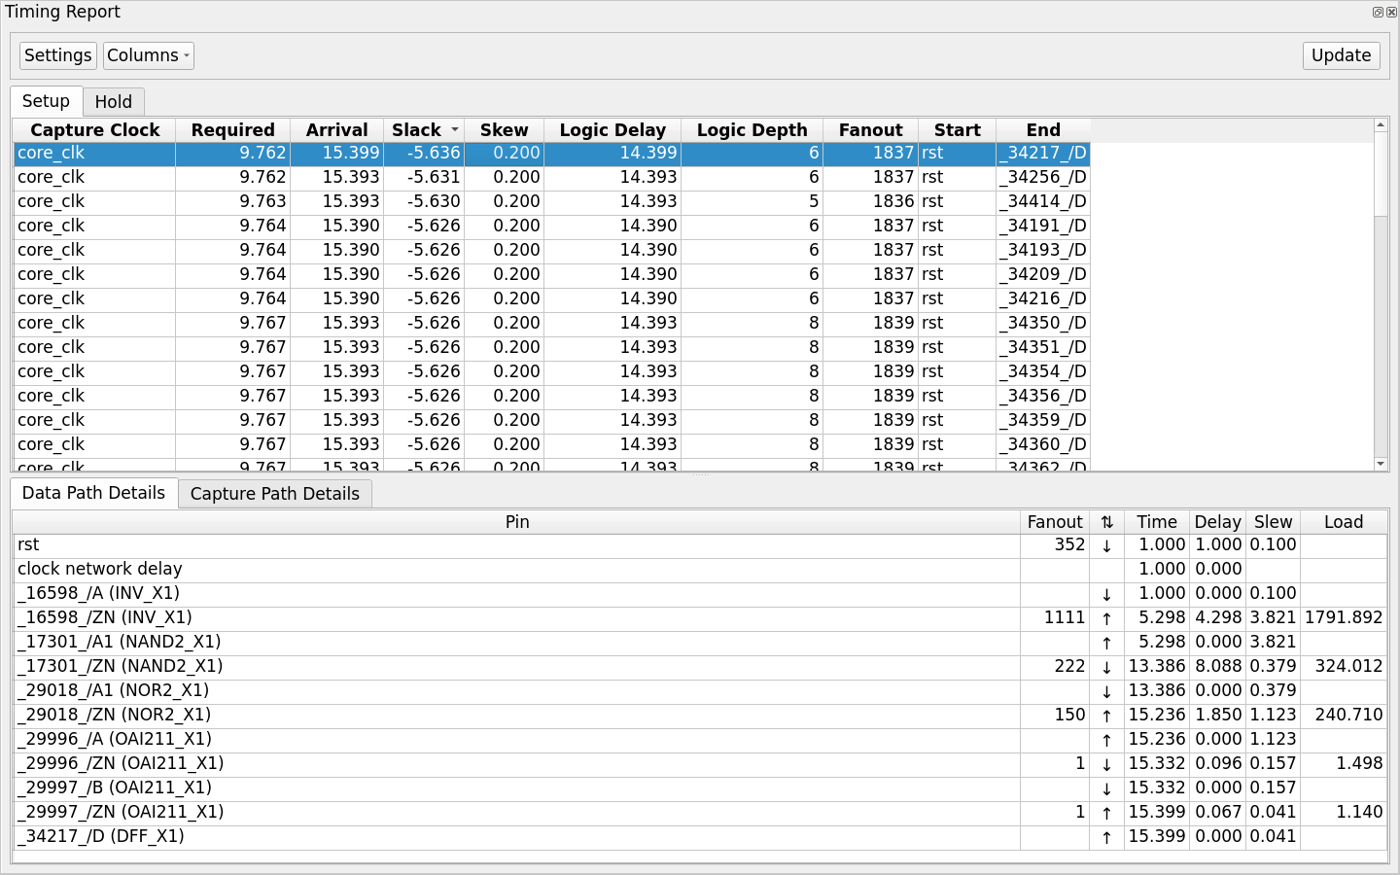
[picture p12: figure]

Shiv Sriram V | 24BVD0168 | L21+L22 | Evidence run: 24 October 2026 | 16

ASSIGNMENT IX - FRONT END / NETLIST TERMINAL EVIDENCE

# Mapped and routed logical regression

The same independent directed architectural scoreboard passes on the routed, mapped netlist using Liberty-derived functional cell models. This is zero-delay simulation without SDF, and is separate from physical LVS.

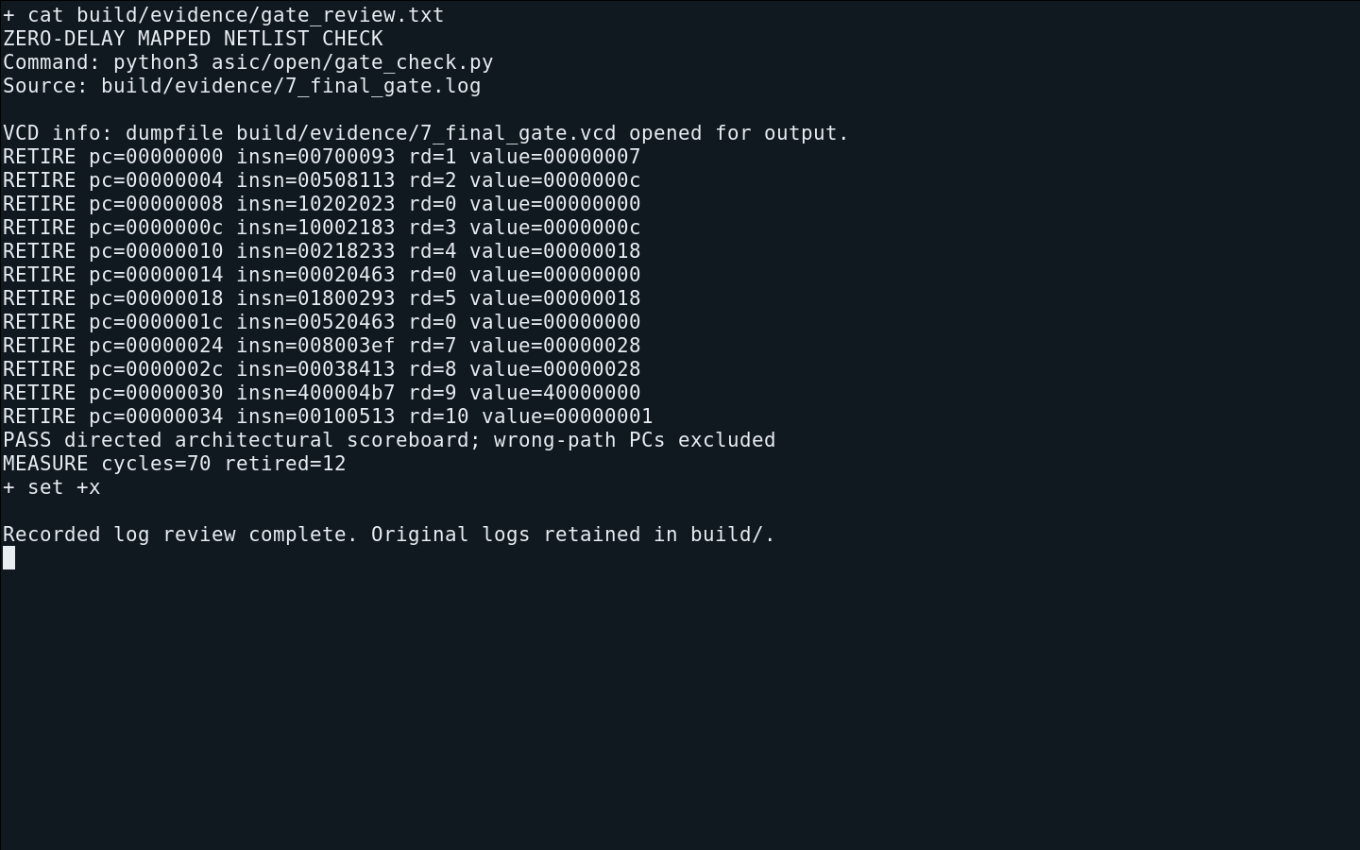
[picture p13: figure]

Shiv Sriram V | 24BVD0168 | L21+L22 | Evidence run: 24 October 2026 | 17

ASSIGNMENT IX - FRONT END / FINDINGS AND LIMITATIONS

# Discussion of front-end results

The directed evidence demonstrates the required dependency and redirect behavior. The broader regression checks instruction semantics and several memory latency configurations. The observed CPI reflects the conservative fetch protocol and memory stalls; five stages alone do not imply ideal throughput.

Technology mapping succeeded, but the initial setup slack is negative. Placement-time resizing substantially changes both timing and area. The front-end report therefore retains the synthesis result and leaves the physically optimized result to Assignment X.

The existing project includes more functionality than the initial RV32I proposal: iterative RV32M, a limited machine-mode environment and optional SoC modules. Only the processor top and M unit are included in the GDS. Formal evidence covers the arbiter for 25 bounded cycles; there is no whole-CPU formal proof or complete privileged-ISA certification.

Supplemental physical LVS passes for the repaired routed processor, including named top ports. Repeated back-end checks report zero antenna markers and zero maximum-capacitance violations. This is a separate check from the front-end zero-delay netlist simulation; full setup, controls and result evidence are documented in Assignment X.

A short readmemh image warning in the older regression means the initialized simulation memory is larger than the loaded program. The directed evidence image uses an explicit range. Assertions and architectural comparisons, rather than the absence of warning text, establish the reported pass results.

Shiv Sriram V | 24BVD0168 | L21+L22 | Evidence run: 24 October 2026 | 18

ASSIGNMENT IX - FRONT END / PROJECT RECORD

# Contributions, scope and reproduction

Contributor / assistance | Recorded role
Shiv Sriram V, 24BVD0168 | Project owner; supplied the processor proposal and existing project repository. No additional team members were provided.
Existing repository | Processor, optional SoC extensions, firmware and regression infrastructure predated this session.
AI-assisted work in this session | Directed hazard test and waveform; technology-mapped synthesis; mapped/post-route directed netlist checks; tool execution, evidence capture and report compilation. Student review and approval of the submitted claims remain with the project owner.

No commits were made or staged. Suggested stage-by-stage commit messages and file groupings are in docs/COMMIT_GUIDE.md. The project includes exact constraints, source scripts, tool outputs and screenshots for independent reproduction.

make pipeline
make all
python3 asic/open/synth.py make closure
make evidence
make submissions
Shiv Sriram V | 24BVD0168 | L21+L22 | Evidence run: 24 October 2026 | 19

ASSIGNMENT IX - FRONT END / REFERENCES

# Source and evidence index

Assignment sources: the supplied Assignment VIII project proposal; ASIC Design Lab QP 9 (1).pdf (Assignment IX, Front End); ASIC Design Lab QP 0.pdf (Assignment X, Back End). Submission 8 duplicates the supplied proposal.

OpenROAD flow and public platform documentation:
https://openroad-flow-scripts.readthedocs.io/en/latest/
Official binary release:
https://github.com/Precision-Innovations/OpenROAD/releases/tag/2024-12-14 LVS source: FreePDK45_for_KLayout - pinned BSD-3-Clause source and license (https://github.com/laurentc2/FreePDK45_for_KLayout/tree/d15da945559773854ca04aeb9bc2c150d55a1e6c)
Evidence location | Content
rtl/ and tb/ | Synthesizable sources and independent directed scoreboard
build/evidence/ | Full regression, hazard/gate logs and waveforms; terminal review text
build/asic/ | Synthesis log/netlist/JSON; ODB, DEF, SDC, STA paths, SPEF, GDS and DRC database
reports/asic_metrics.json | Measured area, utilization, setup/hold slack and tool/platform versions
reports/physical_checks.json | Independent GDS DRC and measured LVS status
reports/lvs_summary.json | Validated cell masters, negative controls and processor comparison counts
reports/closure_summary.json | Final DRC, electrical, timing, functional, power and LVS audit
reports/evidence/ | Unaltered actual GUI and xterm screenshot PNG files
asic/open/README.md | Reproduction, constraints, scope and tool setup
Shiv Sriram V | 24BVD0168 | L21+L22 | Evidence run: 24 October 2026 | 20
