Triumphant-24k/Pipelined-RISC-V-SoC/reports/evidence/1_synth_terminal.png

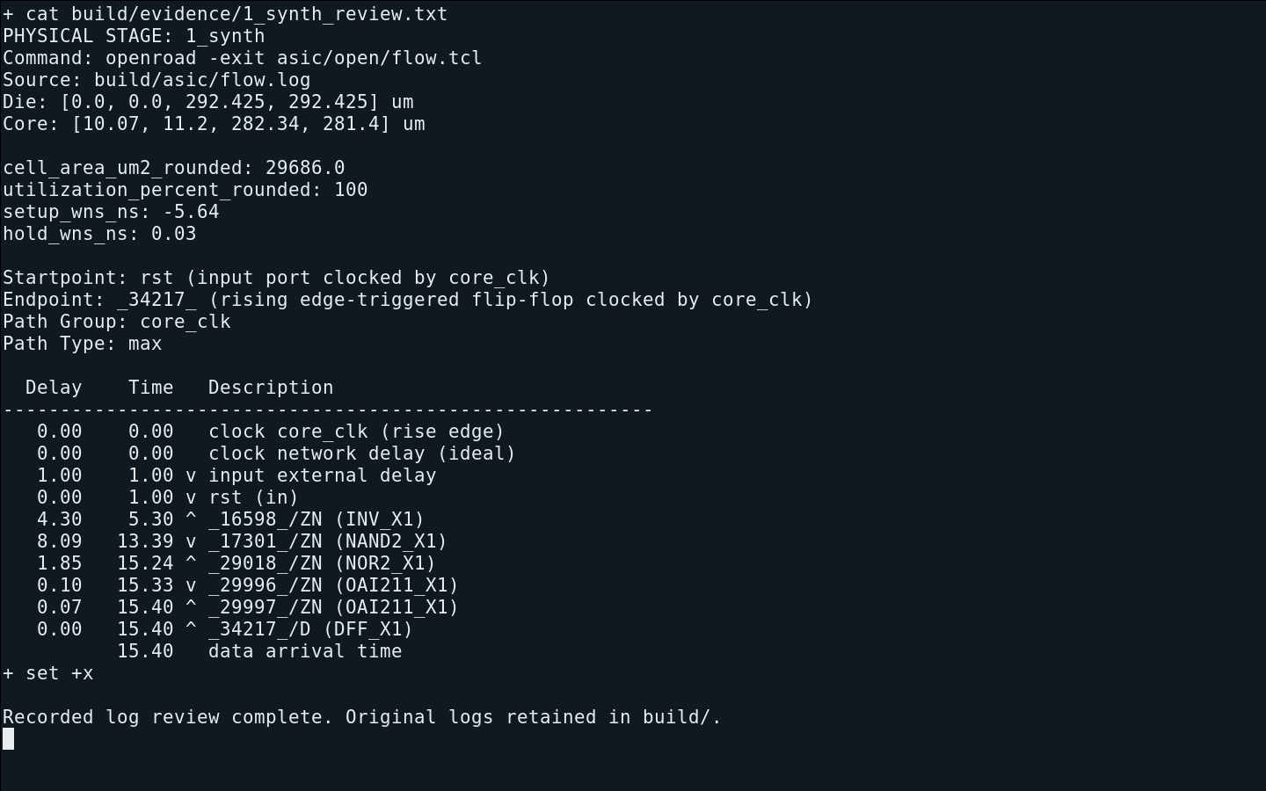
reports/evidence/1_synth_terminal.png
