Triumphant-24k/Pipelined-RISC-V-SoC/reports/evidence/2_floorplan_gui.png

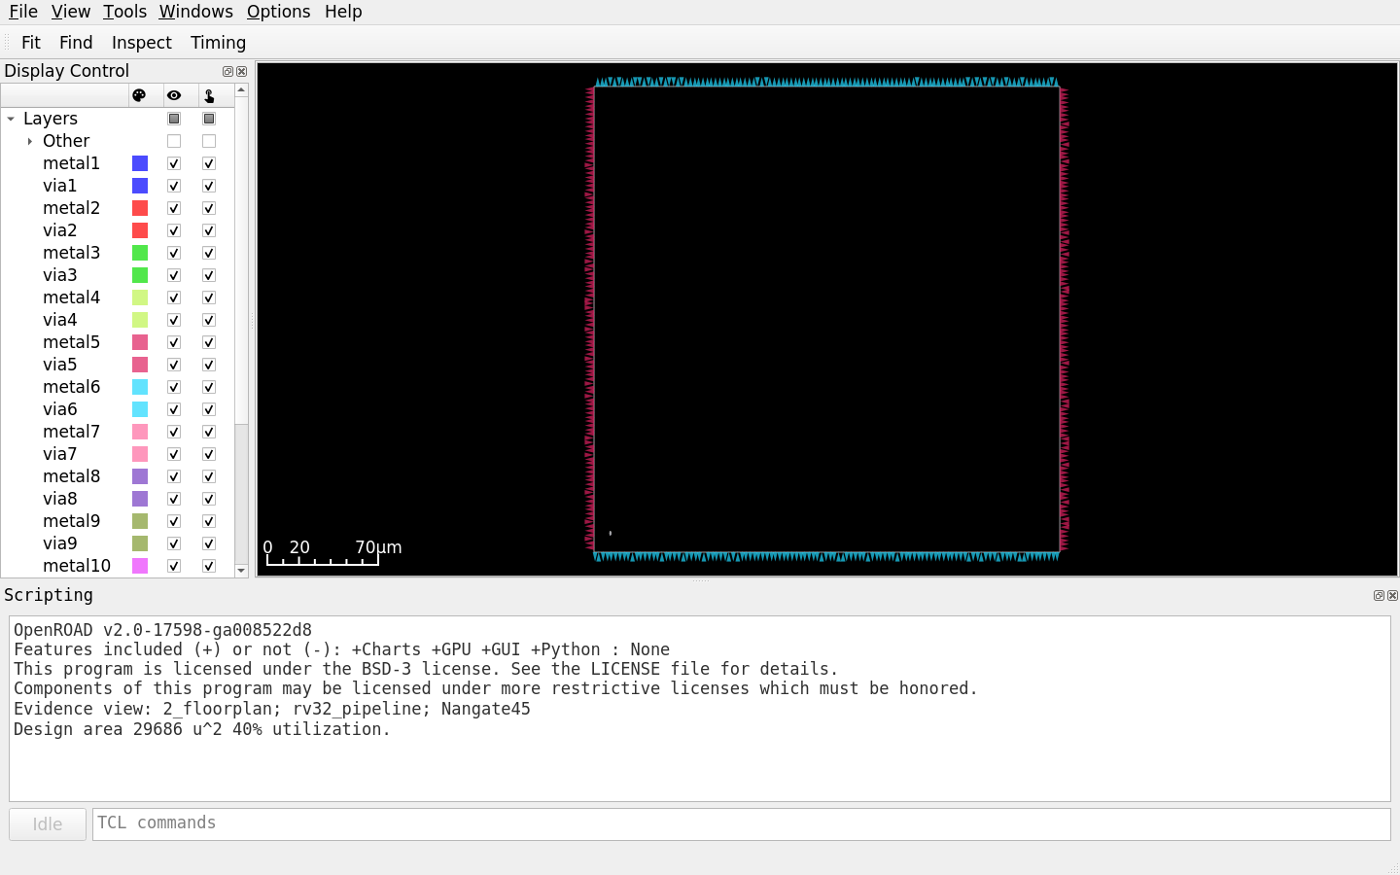
reports/evidence/2_floorplan_gui.png
