Triumphant-24k/Pipelined-RISC-V-SoC/reports/evidence/3_power_gui.png

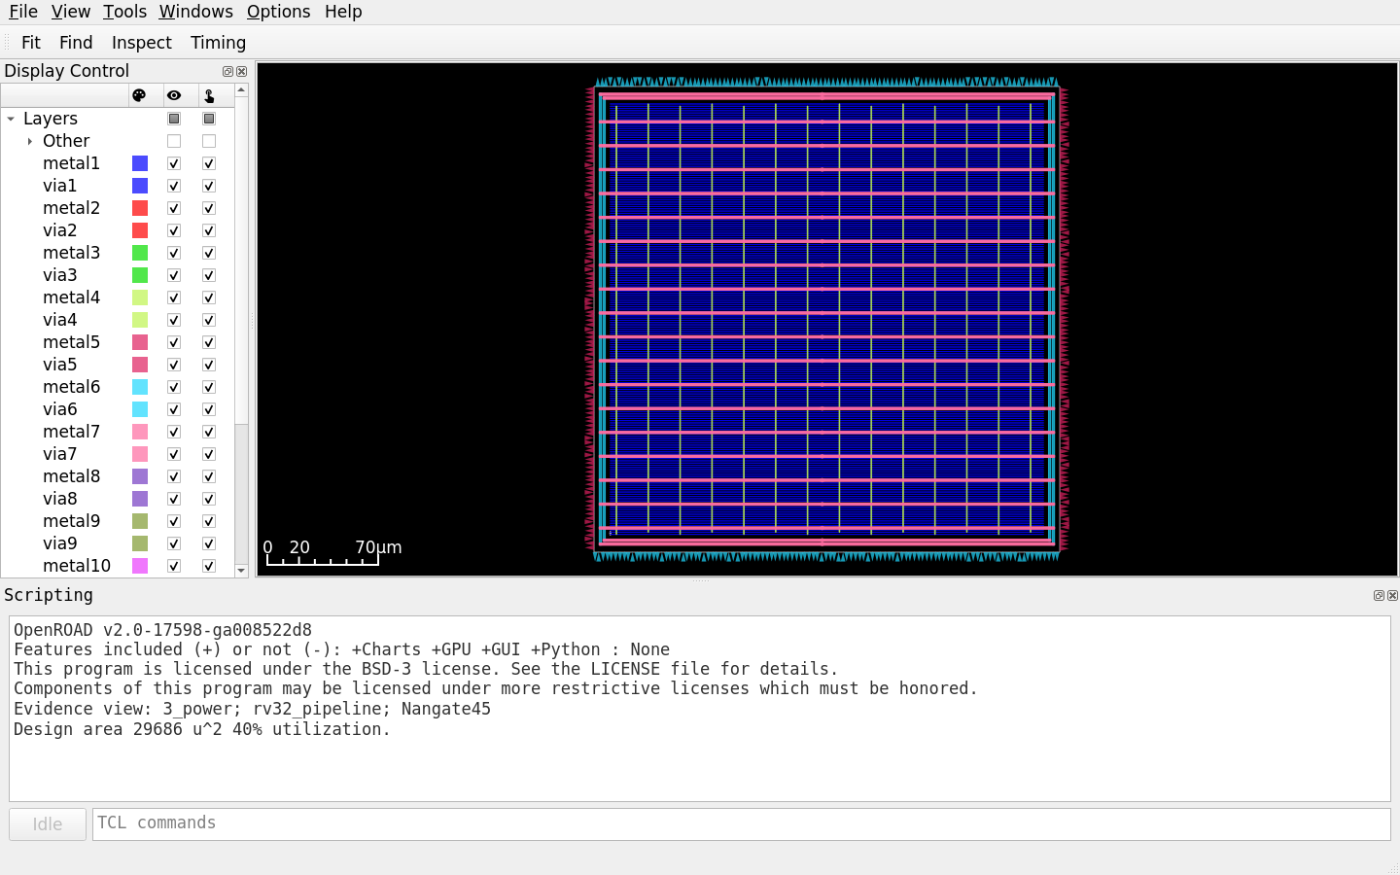
reports/evidence/3_power_gui.png
