Triumphant-24k/Pipelined-RISC-V-SoC/reports/evidence/5_cts_terminal.png

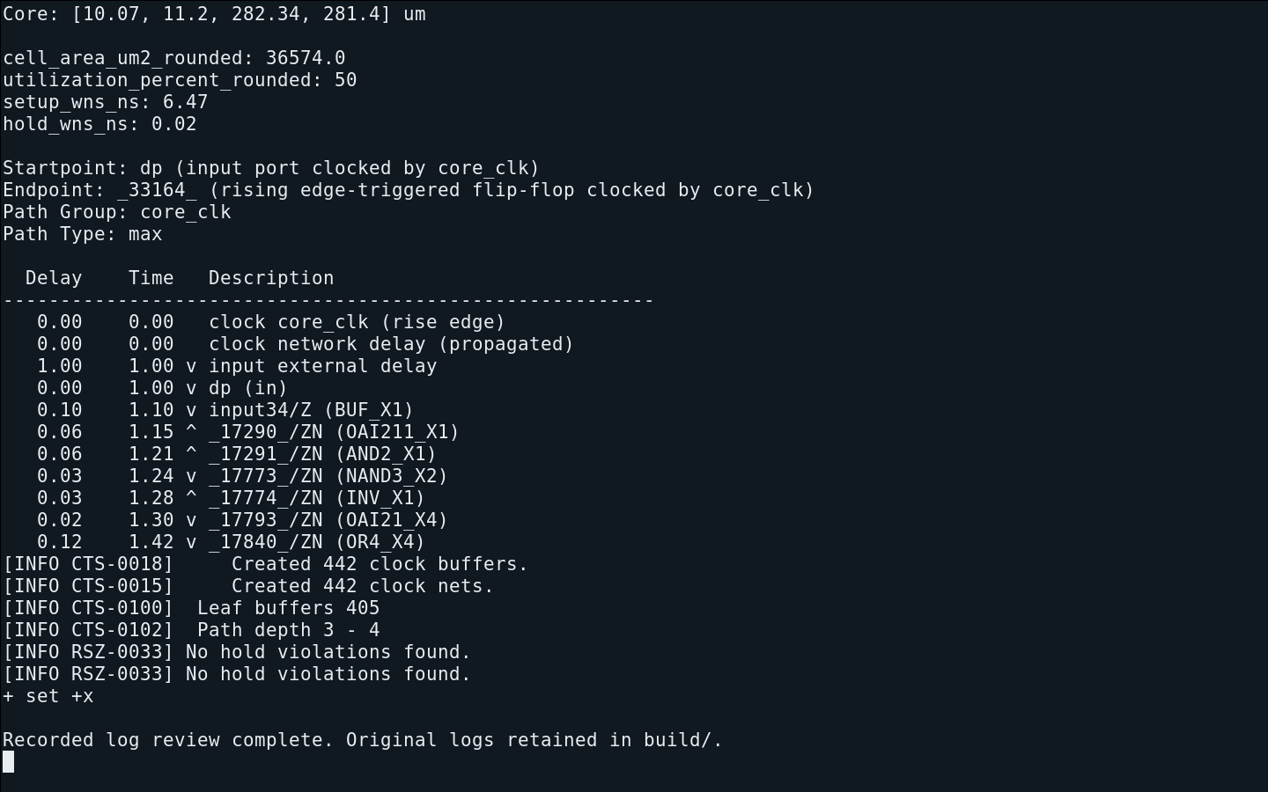
reports/evidence/5_cts_terminal.png
