Triumphant-24k/Pipelined-RISC-V-SoC/reports/evidence/7_final_gui.png

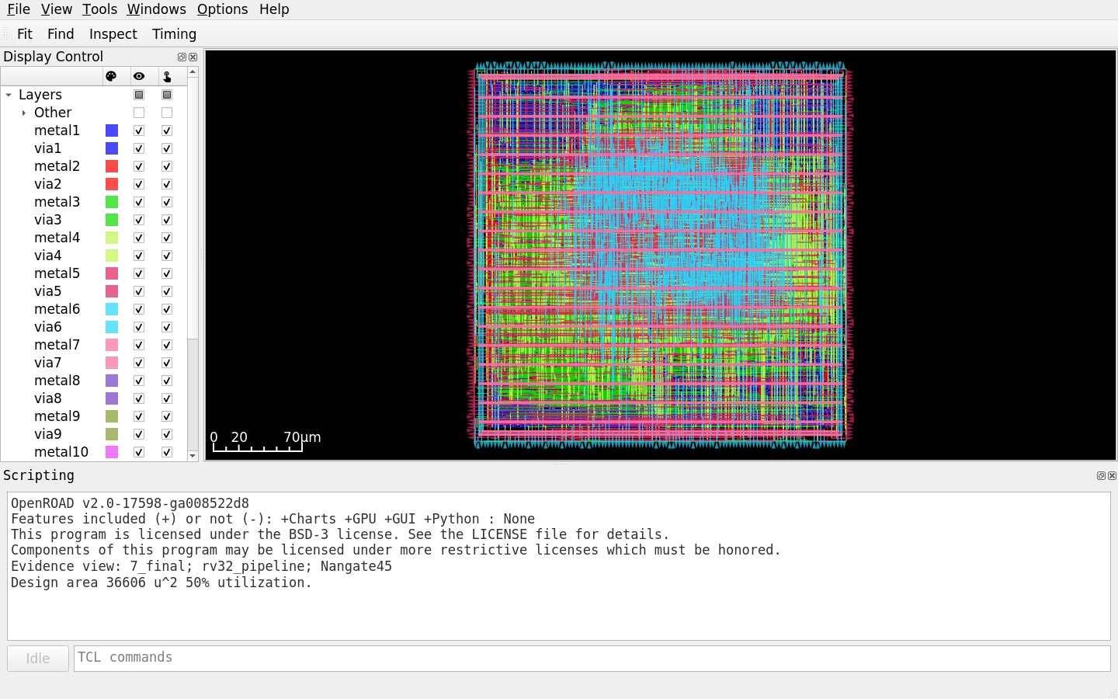
reports/evidence/7_final_gui.png
