Triumphant-24k/Pipelined-RISC-V-SoC/reports/evidence/clock_tree_gui.png

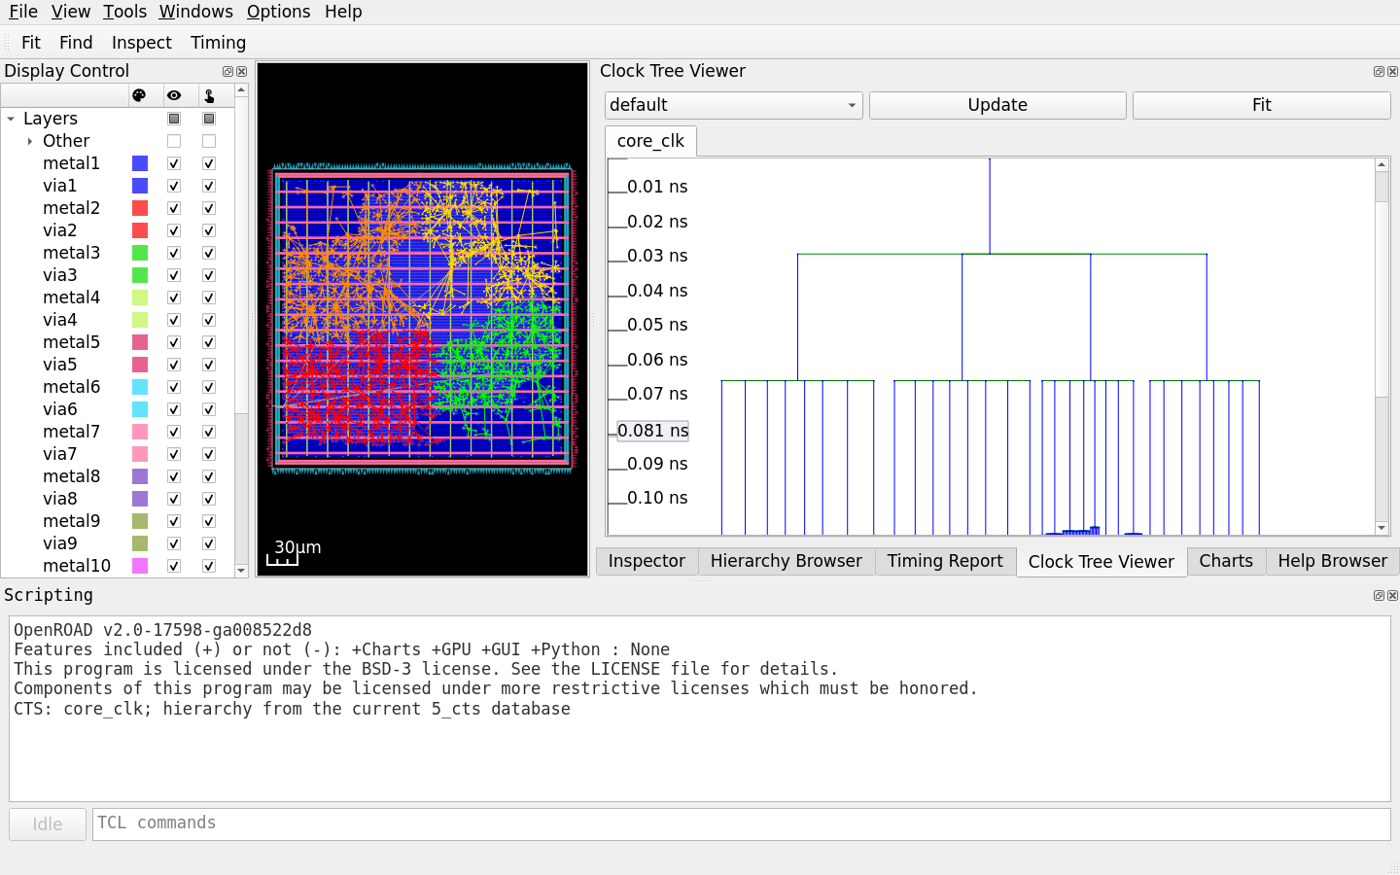
reports/evidence/clock_tree_gui.png
