Triumphant-24k/Pipelined-RISC-V-SoC/reports/evidence/cts_constraint_revision_terminal.png

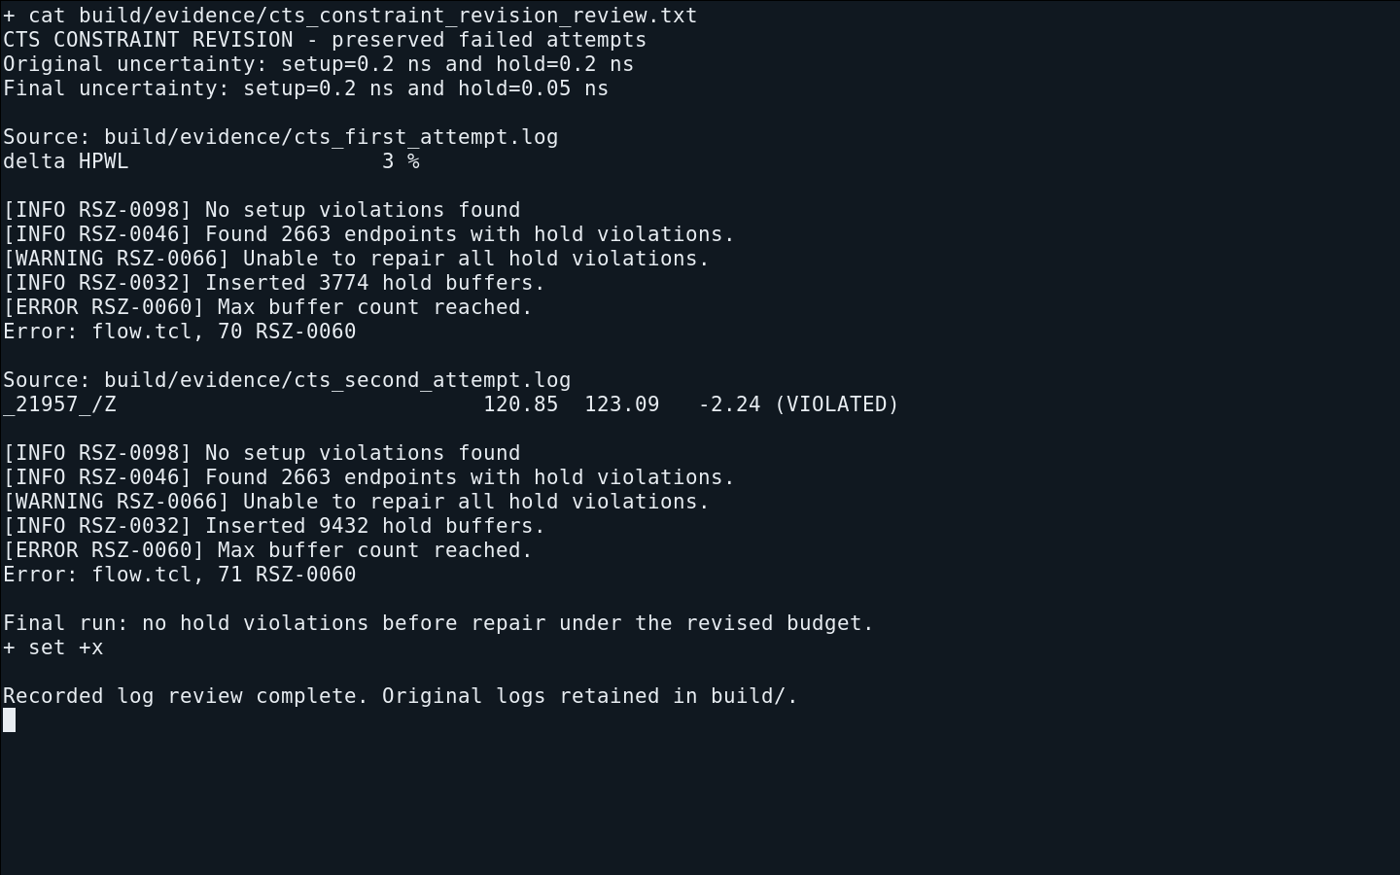
reports/evidence/cts_constraint_revision_terminal.png
