Triumphant-24k/Pipelined-RISC-V-SoC/reports/evidence/electrical_before_terminal.png

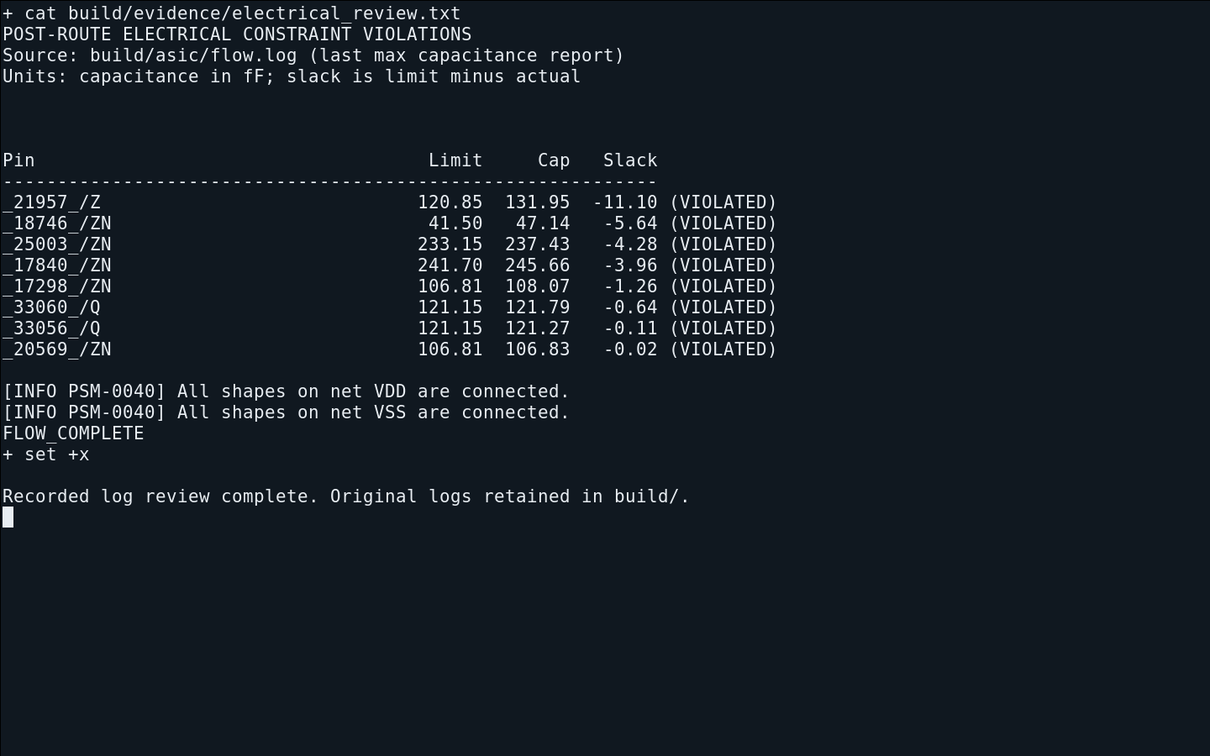
reports/evidence/electrical_before_terminal.png
