Triumphant-24k/Pipelined-RISC-V-SoC/reports/evidence/lvs_gui.png

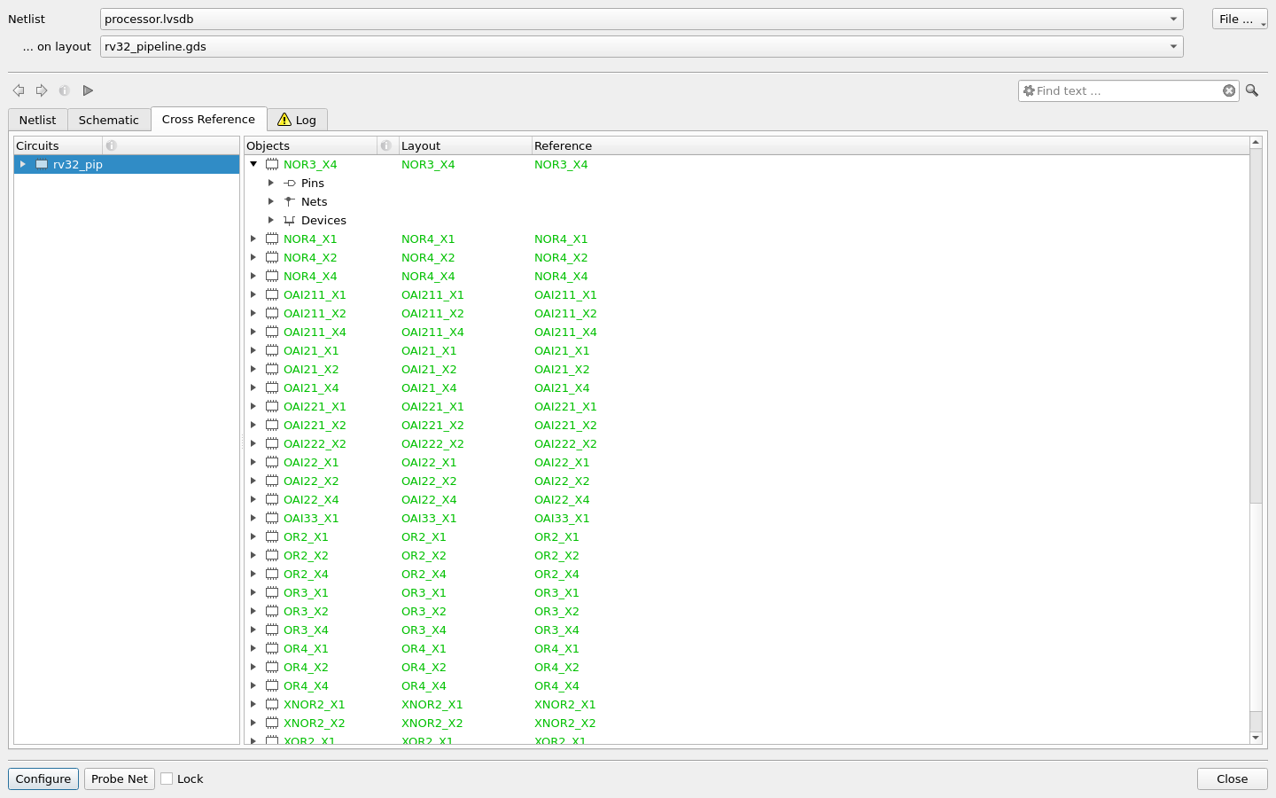
reports/evidence/lvs_gui.png
