Triumphant-24k/Pipelined-RISC-V-SoC/reports/evidence/lvs_negative_gui.png

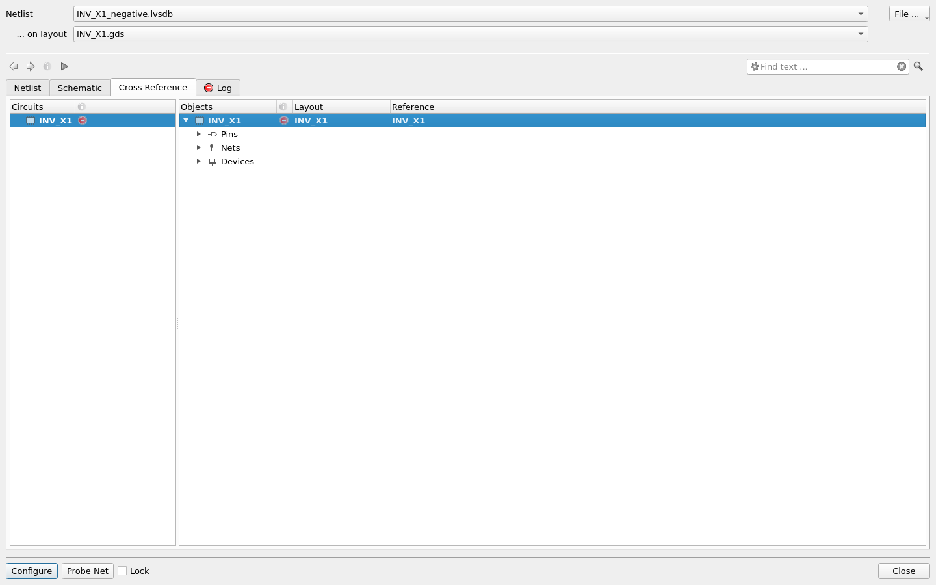
reports/evidence/lvs_negative_gui.png
