Triumphant-24k/Pipelined-RISC-V-SoC/reports/evidence/lvs_processor_terminal.png

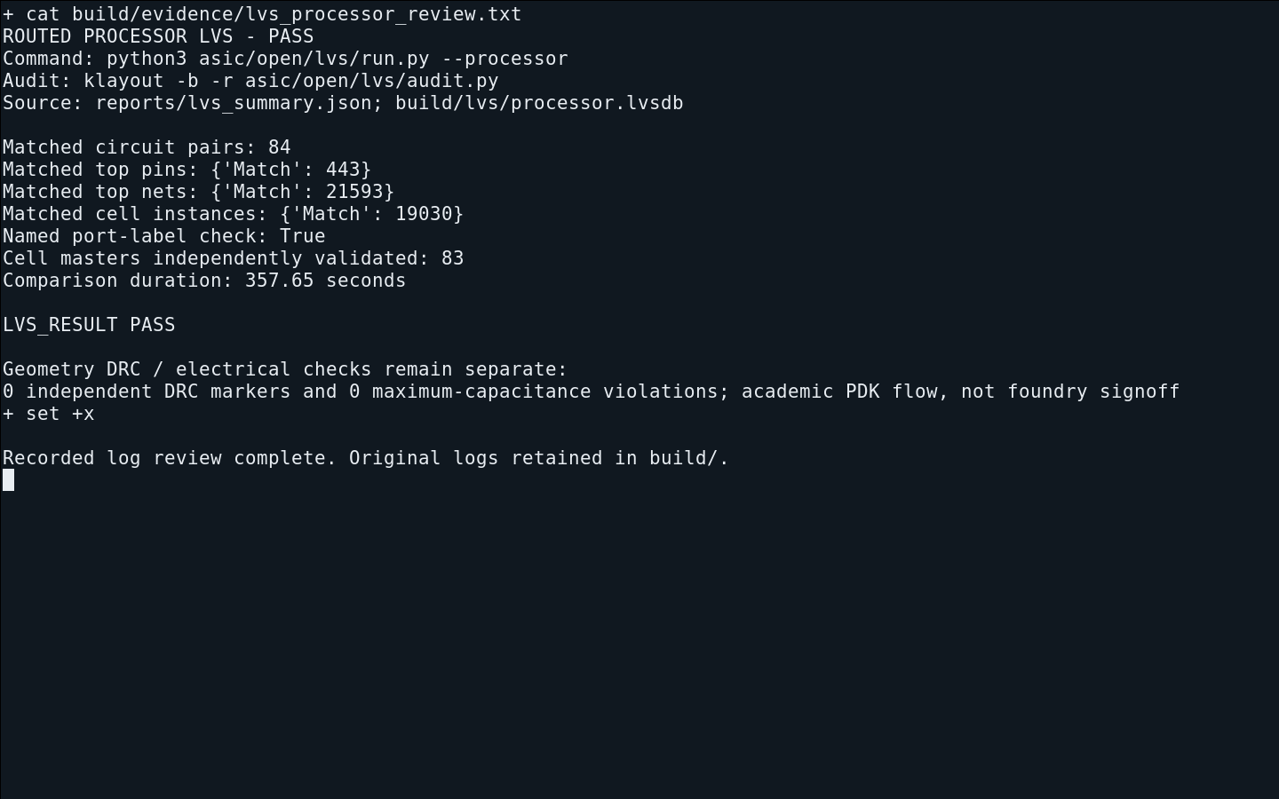
reports/evidence/lvs_processor_terminal.png
