Triumphant-24k/Pipelined-RISC-V-SoC/reports/evidence/physical_checks_gui.png

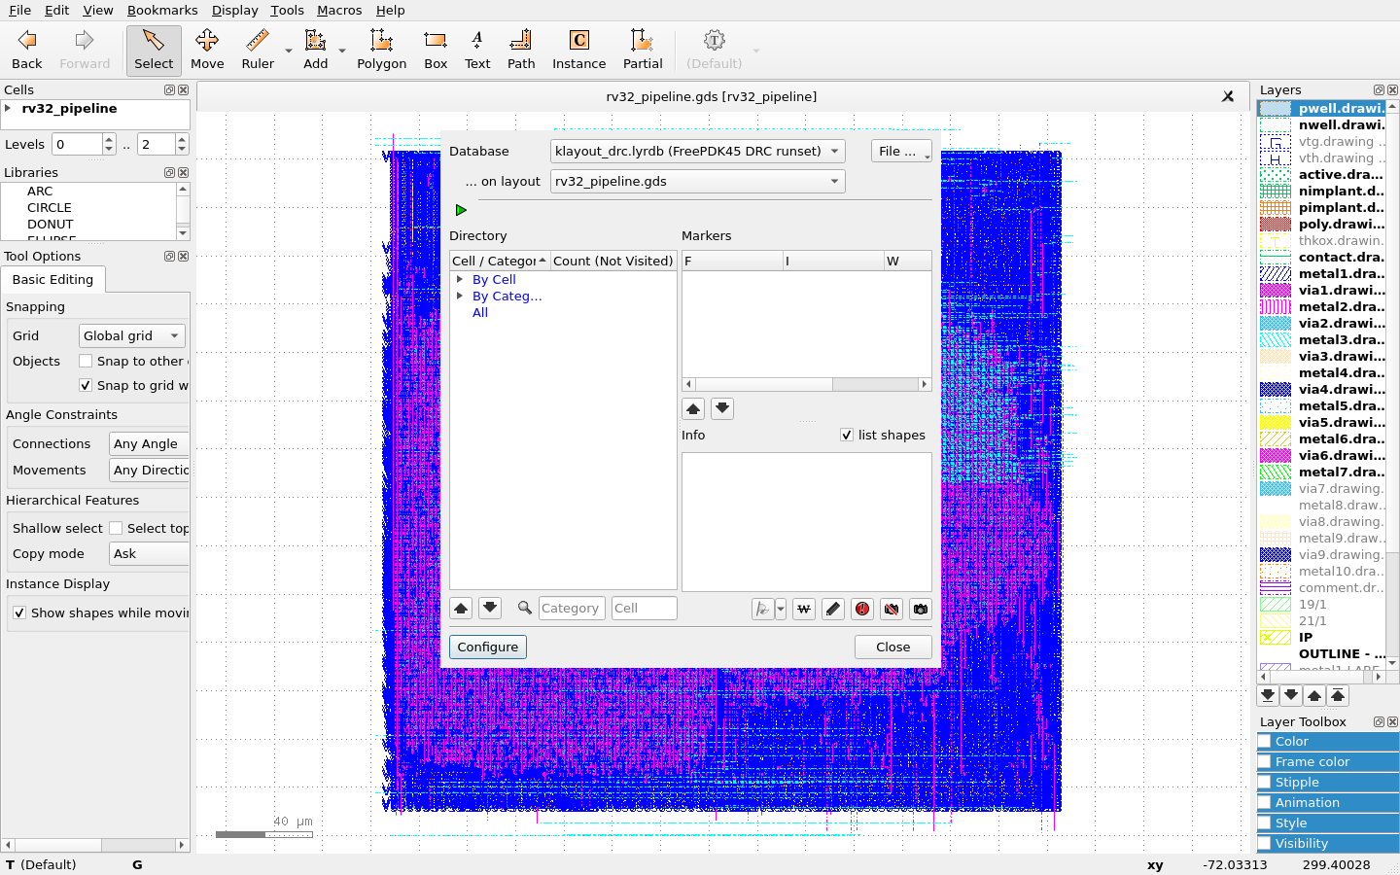
reports/evidence/physical_checks_gui.png
