Triumphant-24k/Pipelined-RISC-V-SoC/reports/evidence/physical_checks_terminal.png

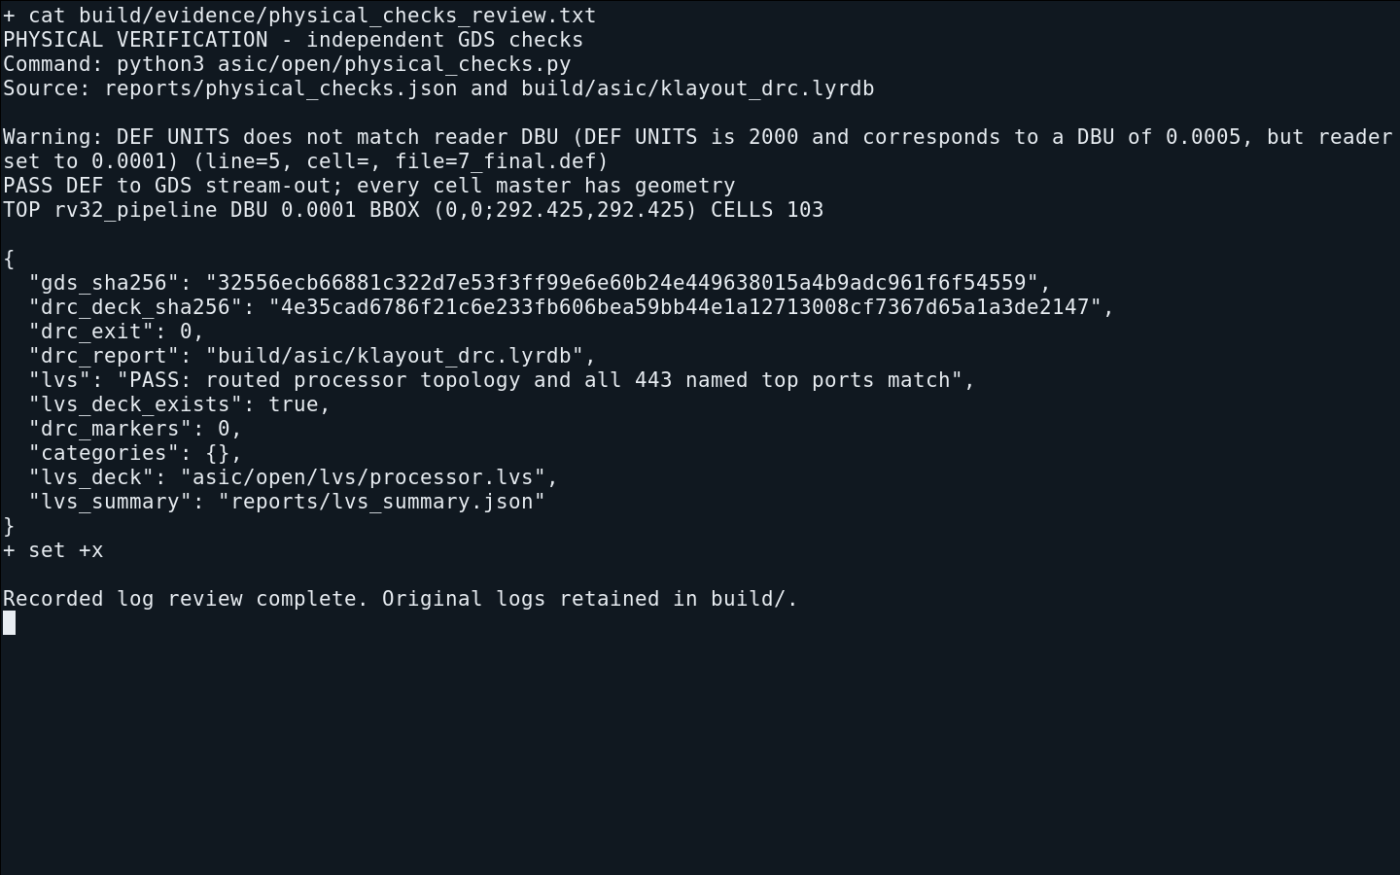
reports/evidence/physical_checks_terminal.png
