Triumphant-24k/Pipelined-RISC-V-SoC/reports/evidence/timing_gui.png

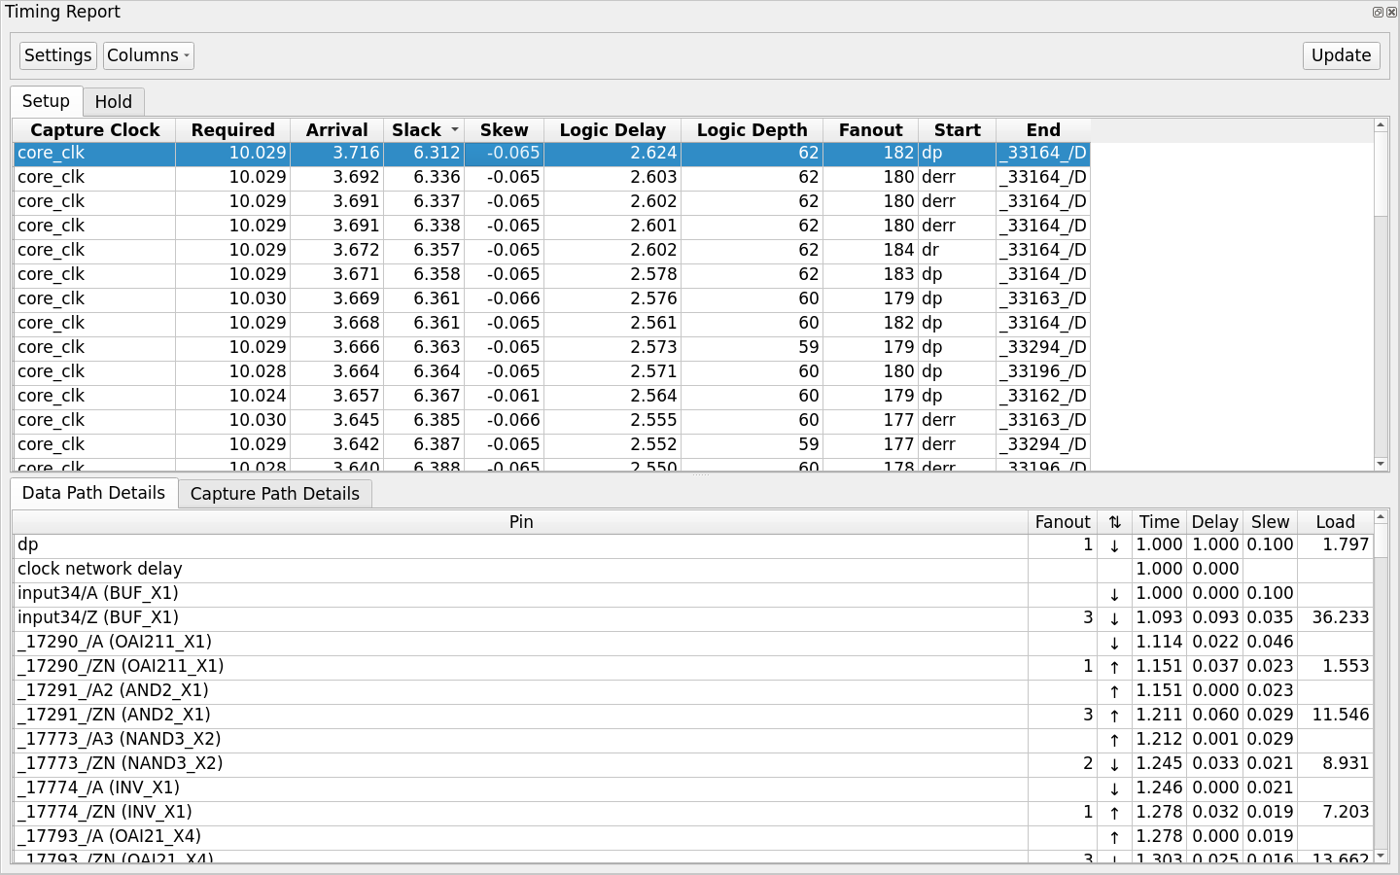
reports/evidence/timing_gui.png
