Triumphant-24k/Pipelined-RISC-V-SoC/reports/evidence/repair_terminal.png

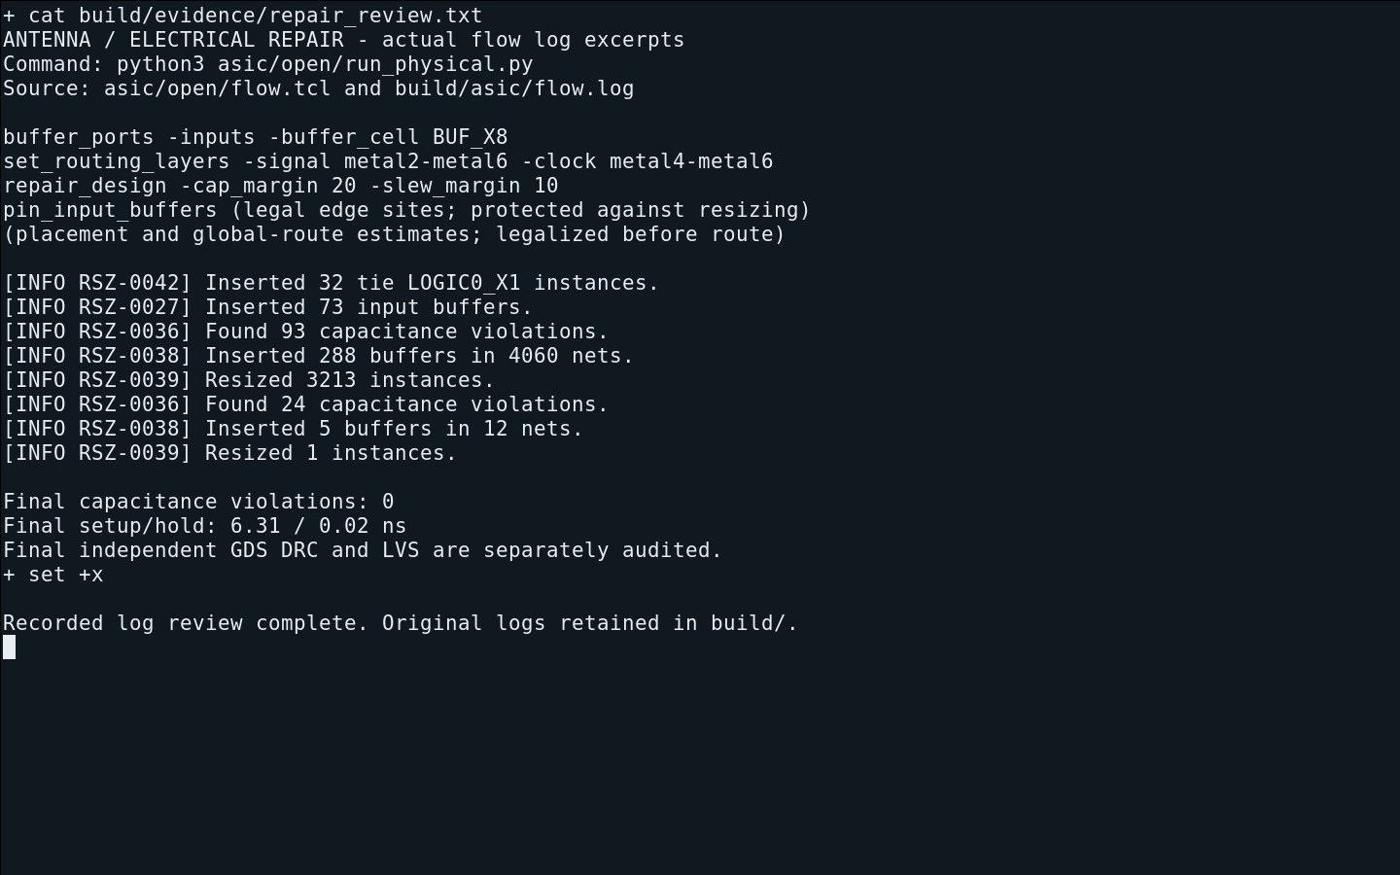
reports/evidence/repair_terminal.png
